WillsanAJantho/Transorter-/Transorter Documents/Poster.jpg

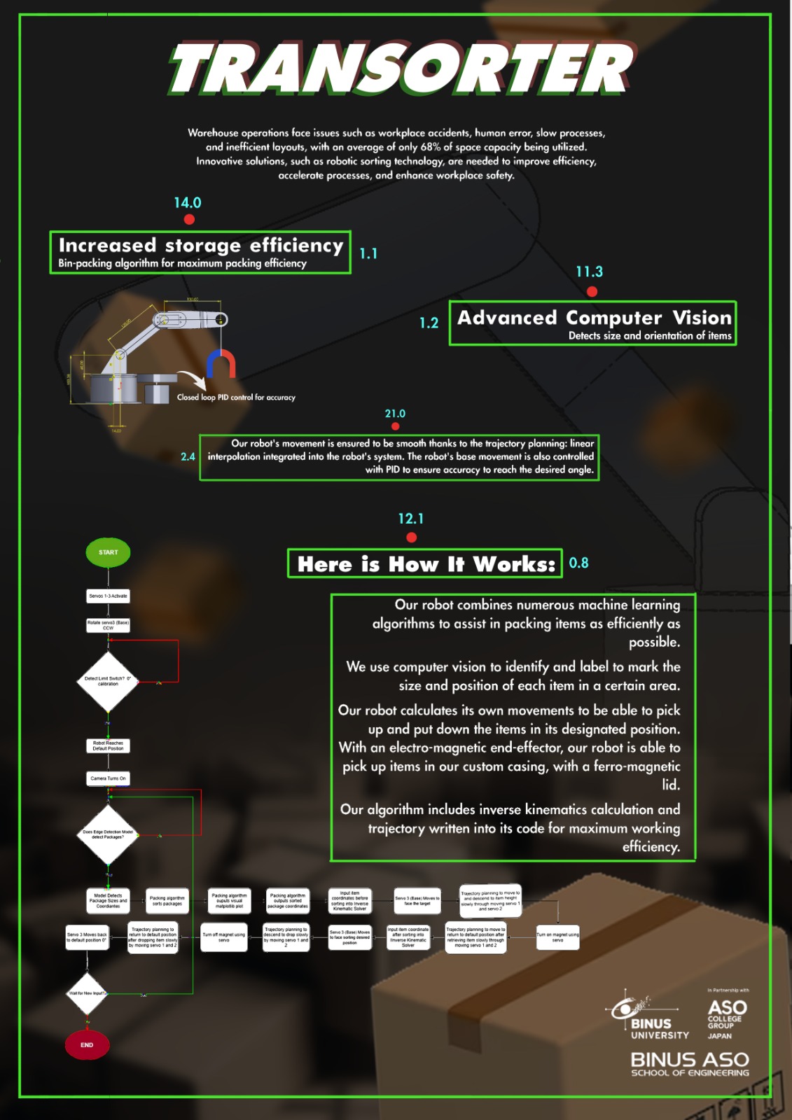
Transorter Documents/Poster.jpg
