WillsanAJantho/Transorter-/Transorter Documents/Laporan TransSorter Final.pdf

# Implementasi Robot Sorting Barang dengan

# Python untuk Machine Learning dan Arduino

# untuk Sistem Kendali

Raphael Nazareth¹

, Samuel Jordan Widjaja¹

, Willsan A Jantho¹

, Efran Leonard Putra Satria¹

, Alifito Marciano Camil¹
,
Dr. Jemie Muliadi, S.T., M.T.²

1Binus ASO School of Engineering, Jl. Alam Sutera Boulevard No.1, Alam Sutera, 15325, Indonesia

2Computer Science Department, School of Computer Science, Bina Nusantara University, Jakarta, 11480, Indonesia

Abstract

Perkembangan teknologi di era modern telah membawa dampak signifikan pada sektor industri, termasuk dalam pengelolaan gudang. Salah satu tantangan utama yang dihadapi dalam operasional gudang adalah kecelakaan kerja akibat sistem penanganan barang yang tidak efisien, serta kesalahan penempatan barang akibat kelalaian pekerja. Selain itu, efisiensi tata letak gudang menjadi isu yang mendesak, mengingat banyak gudang hanya mampu memanfaatkan sebagian kecil dari kapasitas ruang yang tersedia. Untuk menjawab tantangan tersebut, laporan ini membahas penelitian terkait penerapan teknologi robot sorting berbasis machine learning yang terintegrasi dengan sistem kamera untuk melakukan penataan barang secara optimal. Penelitian ini berfokus pada pengembangan dan analisis kinematika serta dinamika lengan robot yang dikendalikan melalui simulasi menggunakan MATLAB, Simulink, dan Simscape. Sistem machine learning diterapkan dengan memanfaatkan algoritma OpenCV untuk identifikasi dimensi barang dan algoritma RectPack untuk optimasi tata letak. Hasil dari penelitian ini diharapkan dapat meningkatkan efisiensi ruang, mempercepat proses penyortiran, serta mengurangi risiko kecelakaan kerja di gudang.

DAFTAR ISI

## BAB I PENDAHULUAN

### 1.1 Latar Belakang

Di era teknologi yang semakin canggih seperti saat ini, perkembangan teknologi memberikan

dampak besar pada sektor industri. Salah satu dampaknya adalah peningkatan kecepatan dan volume

produksi di berbagai industri. Dengan meningkatnya produksi, kebutuhan akan gudang untuk

menyimpan hasil produksi juga meningkat. Namun, banyak permasalahan sering muncul di dalam

operasional gudang. Salah satu permasalahan utama adalah kecelakaan yang terjadi selama proses

penyortiran barang. Hal ini sering kali disebabkan oleh sistem penanganan barang berat yang tidak

tepat, yang dapat membahayakan keselamatan pekerja. Selain itu, banyak gudang masih

mengandalkan tenaga kerja manusia, yang berisiko menimbulkan kesalahan penempatan barang

akibat human error, serta membuat proses penyortiran menjadi lebih lambat [1].

Masalah lainnya adalah tata letak gudang yang tidak efisien. Berdasarkan survei pergudangan

pada tahun 2018, sebagian besar gudang hanya memanfaatkan sekitar 68% dari kapasitas ruang yang

tersedia. Bahkan, hanya 15% gudang yang mampu memanfaatkan 100% kapasitasnya.

Ketidakefisienan ini tidak hanya berdampak pada optimalisasi ruang, tetapi juga memperumit

manajemen logistik di gudang. Oleh karena itu, diperlukan solusi inovatif untuk mengatasi

permasalahan ini, salah satunya adalah dengan menerapkan teknologi modern seperti robot sorting

untuk meningkatkan efisiensi ruang, mempercepat proses, dan meningkatkan keselamatan kerja [2].

### 1.2 Manfaat dan Tujuan Penelitian

Penelitian ini bertujuan untuk mengembangkan sebuah robot yang dilengkapi dengan

microcontroller yang mampu mengintegrasikan kinematika dan dinamika dalam pergerakannya,

sehingga dapat menjalankan tugas penyortiran barang secara presisi dan efisien. Selain itu, sistem

robot ini dirancang untuk memanfaatkan teknologi machine learning dalam bentuk computer vision,

yang memungkinkan robot untuk mengidentifikasi, mengukur, dan mengklasifikasikan benda secara

otomatis berdasarkan data visual. Dengan menggabungkan teknologi ini, sistem mampu

mengoptimalkan proses penataan barang di gudang secara real-time.

Manfaat yang diharapkan dari penelitian ini mencakup tiga aspek utama. Pertama, peningkatan

efisiensi penggunaan ruang di dalam gudang, di mana tata letak barang dapat diatur secara optimal untuk memaksimalkan kapasitas penyimpanan. Kedua, terciptanya lingkungan kerja yang lebih aman

dan terkendali, karena proses penanganan barang berat dan berisiko dapat dialihkan dari pekerja

manusia ke robot, sehingga mengurangi potensi kecelakaan kerja. Ketiga, munculnya peluang

pekerjaan baru yang berfokus pada perawatan dan pengoperasian perangkat berbasis teknologi ini,

yang sejalan dengan kebutuhan tenaga kerja di era industri 4.0.

Adapun inovasi dan aplikasi utama dari penelitian ini meliputi pemanfaatan teknologi

microcontroller dan machine learning untuk meningkatkan efisiensi dalam sektor pergudangan.

Robot yang dikembangkan akan terintegrasi dengan perangkat lunak berbasis computer vision,

memungkinkan proses identifikasi dan penyortiran barang dilakukan secara otomatis dan lebih cepat

dibandingkan metode konvensional. Dengan penerapan teknologi ini, industri pergudangan tidak

hanya dapat meningkatkan produktivitas dan efisiensi, tetapi juga mengadopsi solusi teknologi

canggih untuk menghadapi tantangan masa depan.

### 1.3 Batasan Masalah

Batasan masalah dalam proyek ini dirumuskan sebagai berikut. Barang yang diangkut

berbentuk silinder, sehingga orientasi barang tidak menjadi kendala dan tidak memerlukan rotasi.

Akurasi dalam pengangkutan barang memiliki toleransi sebesar 2–3 cm, yang disebabkan oleh

adanya offset pada end-effector yang tidak sejajar dengan sumbu putar dan desain dari robot memiliki

beberapa kekurangan yang dapat dikembangkan. Selain itu, barang yang diangkat tidak boleh

berwarna hitam, karena sistem machine learning mendeteksi perbedaan warna dalam skala grayscale

dan mengasumsikan alas sebagai warna hitam. Oleh karena itu, warna barang harus lebih terang

dibandingkan dengan warna alas. Sebagai tambahan, barang harus dilengkapi dengan besi pada

bagian atasnya agar dapat diangkat menggunakan magnet.

## BAB II MATERI DAN METODE

### 2.1 Kinematika

Kinematika adalah studi tentang hubungan antara koordinat sendi robot dan posisi spasialnya,

serta merupakan topik fundamental dalam robotika. Untuk mendapatkan posisi yang akurat,

kinematika dapat diselesaikan melalui metode numerik maupun analitis. Misalnya, forward

kinematika memungkinkan kita menentukan posisi end-effector di suatu titik di ruang, merancang

mekanisme yang menggerakkan alat dari titik A ke titik B, atau memprediksi apakah gerakan robot

akan bertabrakan dengan rintangan. Sementara itu, kinematika terbalik atau Inverse kinematic

membantu menghitung nilai sudut setiap sendi yang dibutuhkan untuk mencapai posisi tertentu.

Kinematika hanya memperhitungkan kondisi sesaat koordinat robot, tanpa mempertimbangkan

gerakan yang dipengaruhi oleh gaya atau torsi, yang akan dibahas lebih lanjut dalam dinamika.

Masalah kinematika mungkin terlihat sederhana untuk robot tertentu, seperti robot bergerak yang

dianggap benda kaku, namun membutuhkan kajian lebih mendalam pada robot dengan banyak sendi,

seperti robot humanoid atau mekanisme parallel.

### 2.2 Kinematika Terbalik (Inverse Kinematics)

Dalam dunia robotika, inverse kinematics atau kinematika terbalik adalah salah satu konsep

utama yang digunakan untuk menentukan variabel-variabel pada sambungan robot berdasarkan

posisi dan orientasi yang diinginkan dari efektor akhir (end-effector). Kinematika terbalik bertujuan

untuk menyelesaikan masalah yang berkebalikan dengan forward kinematics, di mana forward

kinematics menghitung posisi dan orientasi dari efektor akhir berdasarkan variabel sambungan yang

diketahui. Pada kinematika terbalik, input utama adalah posisi dan orientasi target dari efektor akhir,

sementara outputnya adalah nilai-nilai variabel pada sambungan, seperti posisi, sudut rotasi, atau

panjang aktuator yang diperlukan untuk mencapai target tersebut. Proses ini melibatkan solusi

persamaan nonlinear yang kompleks, tergantung pada konfigurasi mekanisme robot dan derajat

kebebasannya (Degrees of Freedom, DoFs). Salah satu aplikasi penting dari inverse kinematics

adalah pada kontrol dan pergerakan lengan robot dengan tiga sambungan (three-link arm robot), yang

sering digunakan dalam aplikasi penyortiran barang di gudang atau pengambilan objek pada posisi

tertentu. Three-link arm robot memiliki tiga DoFs yang biasanya berupa rotasi di masing-masing

sambungan. Untuk mencapai posisi yang diinginkan, seperti menjangkau suatu objek pada koordinat tertentu, kinematika terbalik digunakan untuk menghitung sudut rotasi yang diperlukan pada setiap

sambungan.

Sebagai contoh, jika efektor akhir diminta untuk mencapai suatu titik dengan koordinat tertentu

pada bidang dua dimensi (x, y), kinematika terbalik akan menghitung sudut-sudut pada masing-

masing sambungan secara dinamis. Dengan kata lain, kinematika invers menerjemahkan koordinat

target menjadi perintah spesifik berupa sudut rotasi yang harus dicapai oleh masing-masing

sambungan. Pada robot ini, pendekatan matematika yang digunakan melibatkan trigonometri untuk

memecahkan persamaan posisi dari setiap sambungan, dengan mempertimbangkan panjang masing-

masing segmen lengan dan koordinat target. Dalam penelitian ini, kinematika terbalik digunakan

untuk mengatur pergerakan lengan robot yang melakukan proses penyortiran barang di gudang. Hal

ini memastikan efektor akhir dapat mencapai posisi yang diinginkan dengan akurasi tinggi sesuai

kebutuhan. Implementasi kinematika terbalik pada three-link arm robot memberikan solusi yang

efisien untuk berbagai aplikasi robotika, mulai dari pengelolaan inventaris hingga proses manufaktur

presisi [3].

### 2.3 Dynamics

Dinamika robotik adalah bidang studi yang mempelajari perilaku gerak robot sebagai respons

terhadap gaya atau torsi yang diberikan. Dalam robotik, dinamika memainkan peran penting dalam

menjelaskan hubungan antara kontrol (seperti gaya atau torsi pada aktuator) dan perubahan keadaan

robot, termasuk posisi, kecepatan, dan percepatan. Dengan memahami dinamika, kita dapat

merancang kontrol yang memungkinkan robot bergerak secara presisi sesuai dengan tugas yang

diinginkan, meskipun terdapat gangguan atau interaksi dengan lingkungannya. Dinamika robotik

juga memungkinkan prediksi perilaku robot berdasarkan model matematisnya, sehingga sistem

dapat dioptimalkan untuk stabilitas dan efisiensi energi.

Secara umum, model dinamika robot dapat dijelaskan melalui persamaan:

di mana qq adalah posisi sambungan (joint), q˙q˙ adalah kecepatan, dan q¨q¨ adalah

percepatan. Matriks inersia M(q)M(q)menggambarkan distribusi massa robot dan sifat dinamisnya,

sedangkan C(q,q˙)C(q,q˙) mewakili gaya sentripetal dan Coriolis yang muncul akibat gerakan.

Komponen G(q)G(q) melambangkan gaya gravitasi yang bekerja pada robot, dan uu adalah gaya

atau torsi kontrol yang diberikan pada aktuator. Persamaan ini mencakup semua interaksi dinamis

dalam robot, termasuk efek kinematika, inersia, gravitasi, dan gaya-gaya lain yang bekerja pada

sistem.

Dalam implementasi kontrol robot, pemahaman terhadap dinamika sangat penting. Misalnya,

pada sistem kontrol berbasis lintasan, dinamika digunakan untuk menghitung percepatan yang

diinginkan berdasarkan lintasan referensi (qrefqref) yang diinginkan. Selain itu, teknik kontrol

seperti PID (Proportional-Integral-Derivative) atau kontrol ruang operasional memanfaatkan model

dinamika ini untuk mengatur gaya atau torsi sehingga robot dapat mengikuti lintasan dengan presisi

tinggi. Dengan pendekatan ini, robot dapat menangani interaksi yang kompleks, seperti perubahan

beban atau pengaruh lingkungan, dan tetap menjaga kinerja yang optimal [4].

### 2.4 Three Link Planar Robot

Three link planar robot merupakan suatu jenis lengan robot yang memiliki tiga titik sendi,

sehingga robot memiliki sebanyak tiga derajat kebebasan. Dalam membuat sebuah three link planar

robot terdapat beberapa aspek yang perlu dipahami terlebih dahulu. Yang pertama adalah panjang

dari setiap bagian dari lengan pada sebuah robot atau dapat dikatakan jarak antar dua sendi pada robot

yang terdiri dari (I1, I2, I3), dan yang kedua adalah sudut yang dibentuk antara dua sendi pada lengan

robot yang terdiri dari (θ₁, θ₂, θ₃). Sudut pertama pada lengan robot (θ₁) diukur dari sumbu x yang

bersifat tetap, kemudian sendi-sendi selanjutnya (θ₂, θ₃) diukur berdasarkan orientasi pada sendi yang

sebelumnya. Salah satu bagian paling penting dari sebuah lengan robot yaitu end effector merupakan

bagian dari robot yang berinteraksi dengan lingkungan dan memberikan kemampuan bagi robot

untuk menjalankan tugasnya. Dalam sebuah end effector, untuk mengetahui lokasi dari lengannya

x,y, dan φ (phi), perlu didefinisikan terlebih dahulu. x dan y merupakan koordinat yang memberikan

informasi mengenai posisi dari end effector. Sedangkan φ (phi) merupakan sudut yang memberikan

gambaran mengenai posisi dan orientasi end effector [5].

### 2.5 Jacobian

Matriks Jacobian adalah konsep fundamental dalam robotika yang menggambarkan hubungan

matematis antara kecepatan sendi robot manipulator dan kecepatan end-effector. Matriks ini, yang

dilambangkan sebagai J(q), bergantung pada konfigurasi atau posisi robot saat ini. Setiap kolom

dalam matriks Jacobian mencerminkan kontribusi kecepatan dari suatu sendi terhadap kecepatan

linier dan sudut dari end-effector. Secara umum, matriks Jacobian terdiri dari dua komponen utama:

Jv, yang berkaitan dengan kecepatan linier end-effector, dan Jw, yang berhubungan dengan kecepatan

sudutnya. Untuk menghitung Jv, kinematika maju (forward kinematics) digunakan untuk

memodelkan fungsi posisi end-effector (x,y,z) terhadap variabel sendi. Di sisi lain, Jw diperoleh

dengan mempertimbangkan kecepatan sudut, yang dihitung sebagai hasil kali silang antara vektor

sumbu rotasi dengan laju rotasi dari masing-masing sendi. Kombinasi Jv dan Jw menghasilkan

matriks Jacobian lengkap yang memiliki peran penting dalam analisis kecepatan, kontrol gerak, serta

penyelesaian kinematika balik (inverse kinematics). Matriks ini memungkinkan analisis hubungan

antara pergerakan sendi robotik dan gerakan end-effector, menjadikannya alat esensial dalam

pengendalian dan pemrograman robot, khususnya dalam memastikan akurasi dan efisiensi

pergerakan robot [6].

### 2.6 Open CV

Open CV (Open Source Computer Vision Library) adalah pustaka sumber terbuka yang

dirancang khusus untuk aplikasi visi komputer dan pemrosesan gambar secara real-time. Open CV

banyak digunakan dalam berbagai bidang, seperti kecerdasan buatan, robotika, dan augmented reality,

berkat efisiensinya dan kemampuannya yang serbaguna. OpenCV mendukung berbagai bahasa

pemrograman, seperti Python, C++, Java, dan MATLAB, sehingga memudahkan pengembang dari

berbagai platform untuk memanfaatkannya. Selain itu, OpenCV kompatibel dengan sistem operasi

utama seperti Windows, macOS, dan Linux.

Prinsip kerja OpenCV dalam pemrosesan gambar didasarkan pada cara komputer

memperlakukan gambar sebagai kumpulan piksel, di mana setiap piksel direpresentasikan dengan

nilai numerik yang sesuai dengan intensitasnya (untuk gambar grayscale) atau saluran warnanya

(seperti RGB atau format lainnya). Representasi numerik ini memungkinkan komputer untuk

memproses dan menganalisis gambar secara matematis. OpenCV menyederhanakan tugas

pemrosesan gambar yang kompleks dengan menyediakan fungsi-fungsi bawaan untuk operasi seperti

penyaringan gambar, deteksi tepi, ekstraksi fitur, dan transformasi geometris.

Sebagai contoh, dalam proses deteksi tepi, OpenCV menggunakan operasi matematis seperti

perhitungan gradien untuk mengidentifikasi area dalam gambar yang memiliki perubahan intensitas

signifikan, yang biasanya menunjukkan batas objek. Sementara itu, dalam penyaringan gambar,

kernel atau masker konvolusi diterapkan untuk memodifikasi nilai piksel secara sistematis,

memungkinkan tugas seperti pengurangan noise atau penajaman gambar. Desain modular OpenCV

dan algoritma yang dioptimalkan membuatnya menjadi alat yang sangat kuat untuk

mengimplementasikan proses ini dengan efisien, bahkan dalam aplikasi real-time [7].

### 2.7 Rectangle Packing

Algoritma rectangle packing sangat penting dalam grafik komputer dan pengembangan game

untuk menyusun berbagai persegi panjang secara efisien dalam sebuah persegi panjang yang lebih

besar tanpa saling tumpang tindih. Proses ini sangat penting untuk tugas-tugas seperti menyusun

bitmap font ke dalam satu tekstur untuk mengoptimalkan kinerja GPU. Tantangan utama dalam

masalah ini adalah sifatnya yang bersifat NP-hard, yang berarti tidak ada solusi sempurna, sehingga

diperlukan pendekatan heuristik untuk mencapai hasil yang memadai.

Salah satu algoritma yang terkenal dalam bidang ini adalah metode Skyline Bottom-Left (Skyline

BL), yang diimplementasikan dalam pustaka stb_rect_pack. Algoritma ini menggunakan struktur

data yang merepresentasikan “skyline” dari persegi panjang yang sudah disusun, yaitu posisi tepi atas

tertinggi di mana persegi panjang baru dapat ditempatkan. Ketika menempatkan persegi panjang baru,

algoritma ini mencari posisi paling kiri pada skyline di mana persegi panjang tersebut dapat muat,

dengan memastikan penempatannya serendah mungkin. Strategi ini bertujuan untuk meminimalkan

tinggi keseluruhan dari susunan persegi panjang dan mengurangi ruang yang terbuang.

Algoritma Skyline BL bekerja dengan iterasi melalui node dalam linked list yang

merepresentasikan skyline, mengevaluasi potensi posisi untuk persegi panjang baru. Setelah

menemukan tempat yang sesuai, algoritma ini memperbarui skyline untuk mencerminkan

penambahan tersebut, baik dengan menghapus maupun menyesuaikan node yang tumpang tindih

dengan persegi panjang baru. Metode ini menawarkan keseimbangan antara efisiensi dan

kesederhanaan, sehingga menjadi pilihan praktis untuk banyak aplikasi meskipun kompleksitas

masalah rectangle packing cukup tinggi [8].

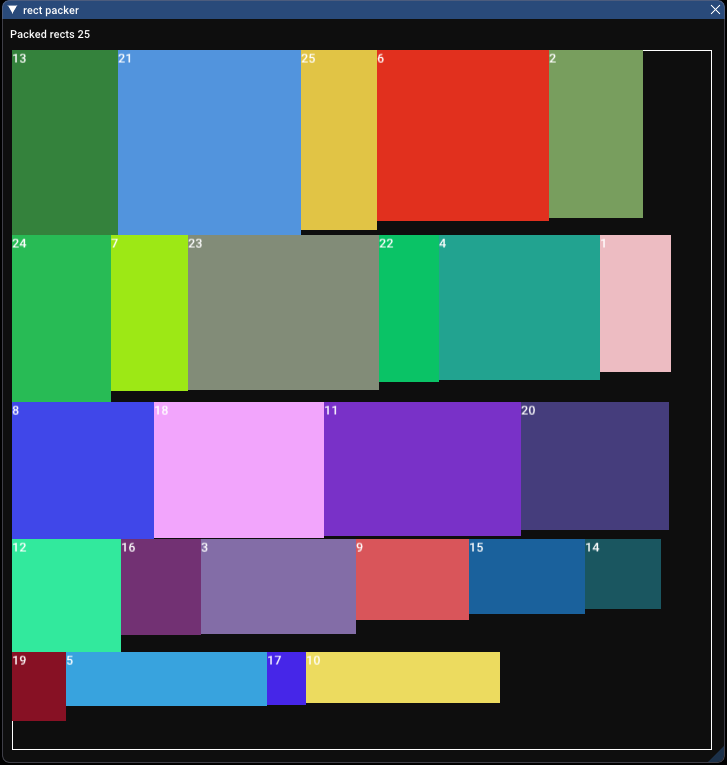
[picture p2: figure]

Figure 1. Rectpack

### 2.8 PID

Kontrol Proportional-Integral-Derivative (PID) adalah salah satu metode sistem kontrol yang

paling banyak digunakan dalam otomasi dan pengendalian proses. Kontroler PID digunakan untuk

terus menerus menghitung nilai error, yaitu selisih antara titik yang diinginkan (setpoint) dan variabel

proses yang terukur. Berdasarkan kesalahan ini, kontroler menerapkan tindakan korektif untuk

menjaga keluaran sistem sedekat mungkin dengan titik setel yang diinginkan. Pendekatan ini sangat

cocok untuk mengatur proses fisik seperti suhu, kecepatan, tekanan, dan tegangan.

Kontroler PID terdiri dari tiga komponen: proportional (P), integral (I), dan derivative (D), yang

masing-masing memberikan kontribusi pada keluaran kontrol. Komponen proportional memberikan

respons langsung terhadap kesalahan saat ini dengan menerapkan koreksi yang sebanding dengan

besarnya kesalahan. Namun, jika hanya bergantung pada komponen proportional, sistem dapat

mengalami kesalahan keadaan tunak (steady-state error), di mana keluaran sistem tetap sedikit

berbeda dari titik setel yang diinginkan.

Komponen integral mengatasi masalah ini dengan mengakumulasi error di masa lalu seiring

waktu dan menerapkan koreksi untuk menghilangkan SSE. Komponen ini mengintegrasikan sinyal

error, memastikan bahwa setiap deviasi yang terus-menerus dari titik setel diperbaiki dari waktu ke

waktu. Namun, komponen integral dapat menyebabkan osilasi dan overshoot jika tidak disetel

dengan benar.

Di sisi lain, komponen derivative memprediksi perilaku sistem di masa depan dengan

menghitung laju perubahan kesalahan. Kemampuan prediktif ini membantu kontroler meredam

osilasi dan meningkatkan stabilitas sistem, terutama pada proses yang mengalami fluktuasi cepat.

Dengan merespons laju perubahan kesalahan, komponen derivative secara efektif memperhalus aksi

kontrol.

Dengan mengkombinasikan ketiga komponen ini, kontroler PID menawarkan strategi kontrol

yang seimbang, meminimalkan kesalahan, mengurangi osilasi, dan meningkatkan stabilitas sistem.

Kontribusi relatif dari komponen P, I, dan D ditentukan dengan menyetel parameter masing-masing,

yang sering disebut nilai gain. Penyelarasan parameter ini sangat penting untuk mencapai kinerja

optimal untuk aplikasi tertentu, karena penyetelan yang tidak tepat dapat menyebabkan

ketidakstabilan atau kontrol yang tidak optimal [9].

### 2.9 ROS

ROS adalah kerangka kerja open-source yang dirancang untuk mengembangkan dan

mengendalikan robot. ROS menyediakan kumpulan alat, pustaka, dan driver untuk membuat aplikasi

robotik yang kompleks. Dengan sistem pesan berbasis publish-subscribe, ROS memungkinkan

komunikasi antara berbagai komponen robot, sehingga mempermudah integrasi sensor, aktuator, dan

algoritma kontrol. ROS mendukung pemrograman multi-bahasa dan desain modular, menjadikannya

fleksibel untuk berbagai platform robot. Ekosistemnya yang luas dengan paket-paket bawaan

mempercepat pengembangan tugas seperti persepsi, navigasi, dan perencanaan gerak [10].

2.10Moveit

MoveIt adalah kerangka kerja perencanaan gerak yang kuat yang dibangun di atas ROS dan

banyak digunakan untuk lengan robotik dan manipulator. MoveIt menawarkan alat untuk inverse

kinematics, perencanaan jalur, deteksi tabrakan, dan optimasi lintasan. MoveIt memungkinkan robot

untuk melakukan pergerakan yang presisi dan aman di lingkungan yang kompleks. MoveIt

terintegrasi dengan baik dengan perangkat keras maupun lingkungan simulasi, menyediakan

visualisasi di RViz dan interaksi dengan pengontrol. Fleksibilitasnya memungkinkan pengembang

untuk menyesuaikan algoritma dan membuat aplikasi untuk tugas seperti pick-and-place, manipulasi

objek, dan pergerakan otonom [11].

### 2.11 Rviz

RViz adalah alat visualisasi di ROS yang memungkinkan pengguna untuk mengamati dan

memeriksa sistem robot dalam lingkungan virtual. RViz dapat menampilkan data sensor, model robot,

lintasan, dan peta secara real-time, sehingga menjadi alat penting untuk memahami bagaimana robot

merasakan dan berinteraksi dengan lingkungannya. Pengembang menggunakan RViz untuk menguji

algoritma, memverifikasi keadaan robot, dan memantau pergerakan tanpa memerlukan perangkat

keras fisik. Dengan arsitektur berbasis plugin, RViz memungkinkan kustomisasi untuk kebutuhan

tertentu, seperti menampilkan visualisasi 3D dari jalur robot atau titik awan dari sensor [12].

2.12Gazebo

Gazebo adalah lingkungan simulasi berbasis fisika untuk menguji dan membuat prototipe sistem

robotik. Gazebo menyediakan pemodelan realistis untuk robot, sensor, dan lingkungan, lengkap

dengan gravitasi, gesekan, dan properti fisik lainnya. Gazebo memungkinkan pengembang untuk

memvalidasi algoritma seperti perencanaan gerak atau navigasi tanpa memerlukan robot fisik.

Simulasi ini terintegrasi dengan baik dengan ROS, memungkinkan pertukaran data antara simulasi

dan node ROS secara mulus. Dengan menyediakan platform yang aman dan hemat biaya, Gazebo

sangat cocok untuk pengembangan cepat, pengujian, dan pelatihan model pembelajaran mesin untuk

aplikasi robotik [13].

2.13Alat & Bahan

### 2.12.1 Alat

- Servo 360
- Servo 180
- Komponen 3D print
- Rotary encoder
- Elektromagnet
- Limit switch
- Power supply

### 2.12.2 Bahan

- SolidWorks, untuk melakukan pemodelan robot
- Matlab, simulink, simscape, untuk membuat simulasi robot dan tuning PID
- Visual Studio Code, untuk menjalankan machine learning

## BAB III PROSEDUR

Hal pertama yang dilakukan dalam perancangan robot sorting adalah menentukan end effector

yang akan digunakan. Pilihan end effector yang dipertimbangkan mencakup gripper dan suction.

Namun, pilihan akhir jatuh pada end effector berupa elektromagnet karena dinilai lebih efisien dan

praktis baik dari segi pembuatan maupun penggunaan. Setelah end effector ditentukan, langkah

berikutnya adalah memilih algoritma machine learning yang sesuai. Algoritma yang dipilih meliputi

OpenCV untuk image processing dan pengukuran dimensi benda, serta algoritma Rectangle Packing

untuk mengatur tata letak barang agar lebih efisien.

Selanjutnya, pemilihan komponen robot dilakukan dengan memperhatikan kinerja dan performa

sistem secara keseluruhan. Komponen utama yang digunakan mencakup servo motor, lengan robot,

dan sensor. Servo motor terdiri dari dua jenis: servo 180° (positional) untuk pergerakan terbatas

dengan sudut rotasi tertentu, dan servo 360° (continuous) yang digunakan pada basis robot untuk

memungkinkan rotasi penuh. Servo 360° ini dilengkapi dengan rotary encoder yang berfungsi untuk

membaca rotasi dengan presisi yang cukup tinggi sehingga dapat mencapai sudut yang diinginkan.

Lengan robot dirancang agar memiliki bobot seringan mungkin untuk menghindari beban

berlebih pada servo, memastikan servo dapat beroperasi dengan optimal. Perancangan lengan juga

mempertimbangkan pusat massa dan daya tahan material untuk menjaga stabilitas dan keandalan

sistem. Sensor rotary encoder diintegrasikan pada servo base untuk memberikan kontrol yang lebih

akurat terhadap sudut rotasi.

Dengan langkah-langkah ini, perancangan robot dilakukan secara sistematis sehingga setiap

komponen dan algoritma dapat bekerja secara harmonis untuk mendukung efisiensi dan performa

robot yang maksimal.

Robot ini memanfaatkan teknologi 3D design dalam perancangannya sehingga dapat

menciptakan sebuah struktur robot yang kokoh. Part untuk robot ini dirancang menggunakan

software SolidWorks dan setelah banyak revisi rancangan yang dilakukan hasil akhir bentuk dari

robot ini seperti pada gambar di bawah ini.

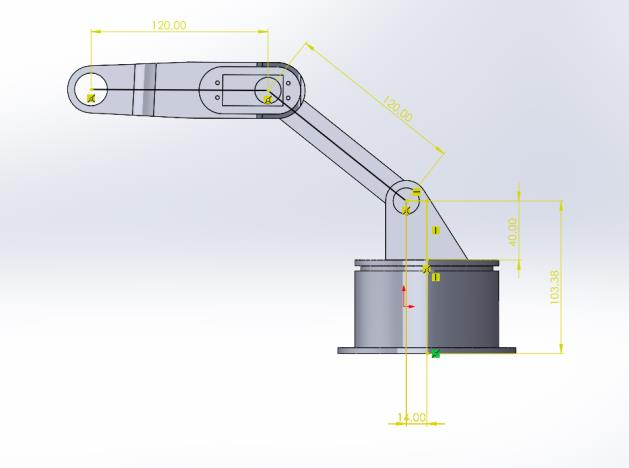
[picture p3: figure]
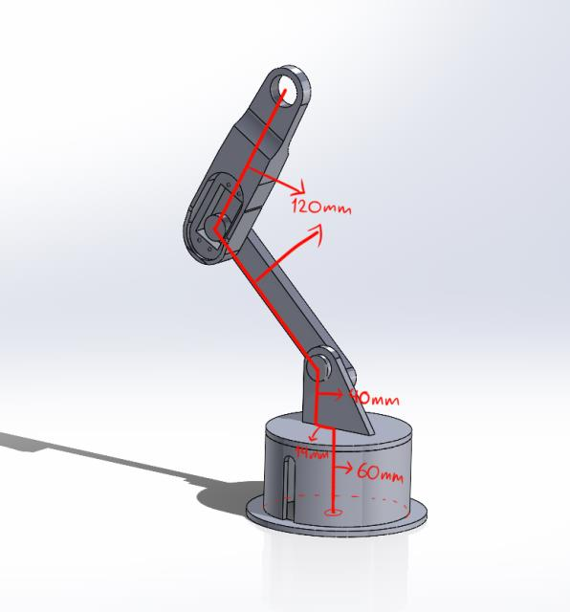
[picture p4: figure]

Berdasarkan gambar di atas, penempatan servo yang digunakan dalam robot ini adalah pada

kedua sendi robot yang merupakan lengan dari robot tersebut yang menggunakan servo 180 dan pada

alas dari robot yang menggunakan servo 360 yang bertujuan untuk mengatur arah robot tersebut

menghadap untuk saat mengambil barang.

Untuk mengidentifikasi koordinat dan ukuran benda berbentuk silinder yang akan diambil,

sebuah kamera digunakan dan diletakkan tepat di atas area penyimpanan awal benda. Dengan

menggunakan kamera tersebut, algoritma computer vision yang didukung oleh OpenCV diterapkan.

OpenCV memungkinkan identifikasi benda berdasarkan fitur visual seperti bentuk melingkar,

diameter, dan posisi koordinat. Setelah koordinat dan ukuran benda berhasil dideteksi, algoritma

Figure 2. Robot Dimensions & Design

Rectpack dapat disesuaikan untuk menyusun tata letak benda-benda berbentuk lingkaran secara

efisien dalam suatu area terbatas. Rectpack, meskipun umumnya dirancang untuk objek berbentuk

persegi panjang, dapat dimodifikasi atau digabungkan dengan pendekatan lain untuk menangani

benda berbentuk bulat. Kombinasi algoritma ini memungkinkan sistem untuk mengidentifikasi,

mengatur, dan memanfaatkan ruang penyimpanan dengan lebih optimal sesuai dengan bentuk benda.

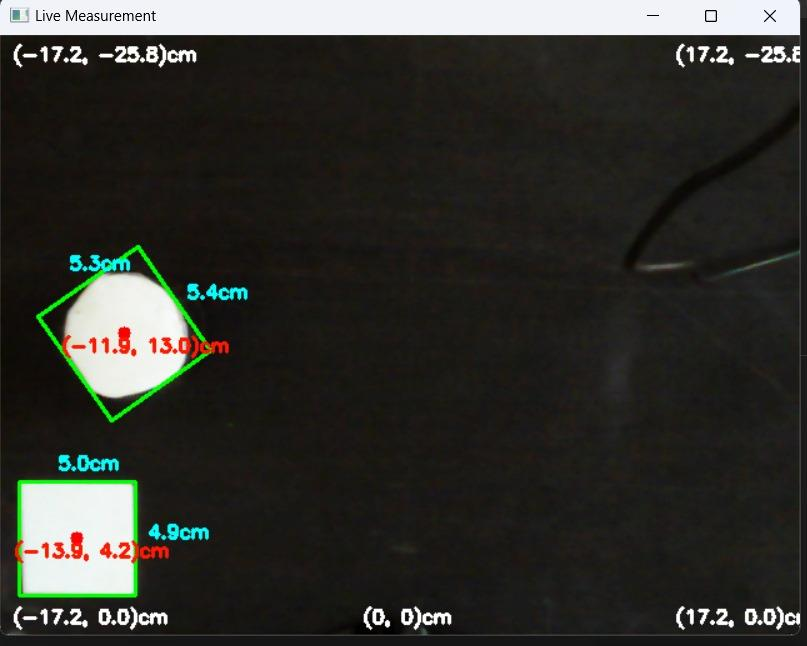
[picture p5: figure]

Figure 3. Live Camera Measurement (OpenCV)

Pada gambar di atas, kita dapat melihat cara kerja OpenCV, pertama, OpenCV memanfaatkan

kemampuan edge detection, untuk mengetahui batas-batas objek yang terdeteksi dan memberikan

ukuran ukuran. Kemudian kita menggunakan kemampuan pemetaan koordinat/piksel untuk

mendeteksi lokasi/koordinat objek silinder. Kubus yang terlihat di kiri bawah gambar diatas berfungsi

sebagai titik referensi yang diatur secara manual, untuk memastikan bahwa untuk memastikan skala

pengukuran sudah akurat.

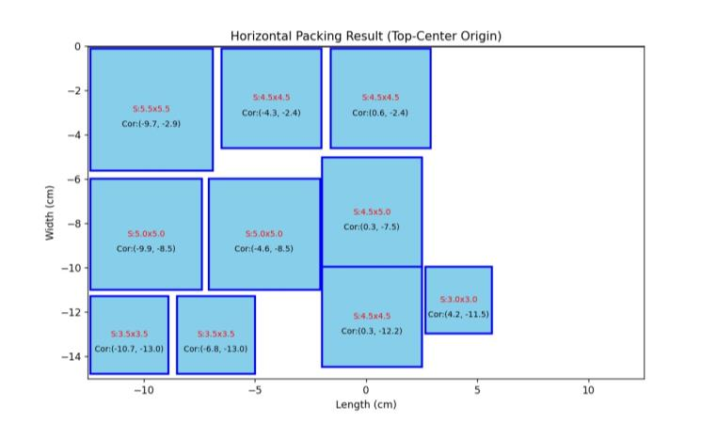
[picture p6: figure]

Figure 4. Rectpack result

Setelah deteksi ukuran dan posisi objek silinder dilakukan oleh OpenCV, variabel-variabel

tersebut kemudian dimasukkan ke dalam algoritma 2D-bin packing yang dikenal sebagai rectpack.

Algoritma packing ini kemudian memproses silinder, yang telah ditafsirkan ulang sebagai kotak dan

atau persegi panjang, dan menghasilkan cara pengemasan yang optimal berdasarkan perhitungannya.

Hasil dari algoritma ini kemudian ditampilkan secara visual di layar kepada user melalui penggunaan

library matplotlib. Memungkinkan pengguna untuk melihat koordinat silinder setelah di packing.

Sebelum dilakukan pengerjaan yang lebih lanjut untuk robot, dilakukan simulasi gerak robot

yang dilakukan dalam matlab, simulink, simscape, dan ROS.

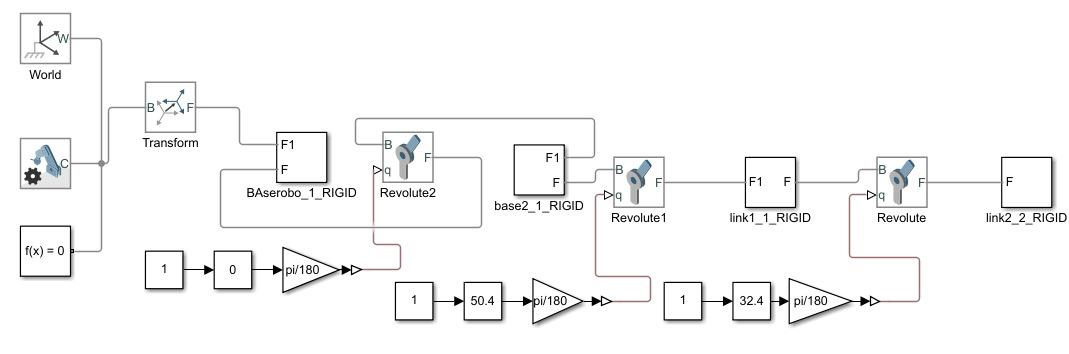
[picture p7: figure]

Figure 5. Model Simscape Robot

Model Simscape yang ditampilkan merupakan simulasi untuk robot 3 link yang dirancang

menggunakan komponen rigid dan sambungan revolute. Sistem ini dimulai dengan kerangka

referensi dunia (World Frame) yang menjadi acuan utama posisi dan orientasi robot dalam ruang 3D.

Transformasi digunakan untuk menghubungkan dunia ke basis robot, memungkinkan integrasi gerakan dengan lingkungan simulasi. Robot terdiri dari tiga sambungan revolute, masing-masing

memungkinkan gerakan rotasi yang merepresentasikan derajat kebebasan (DOF) pada setiap joint.

Sambungan ini menggerakkan komponen rigid yang membentuk struktur fisik robot, seperti basis,

link 1, dan link 2. Input kontrol diberikan dalam bentuk nilai rotasi, yang kemudian dikonversi dari

derajat ke radian agar sesuai dengan perhitungan simulasi. Setiap gerakan dihitung berdasarkan

hubungan antar joint dan link, menghasilkan visualisasi kinematika robot, termasuk pergerakan ujung

robot (end-effector). Secara keseluruhan, model ini memungkinkan analisis kinematika dan validasi

desain robot 3 link sebelum diterapkan secara fisik.

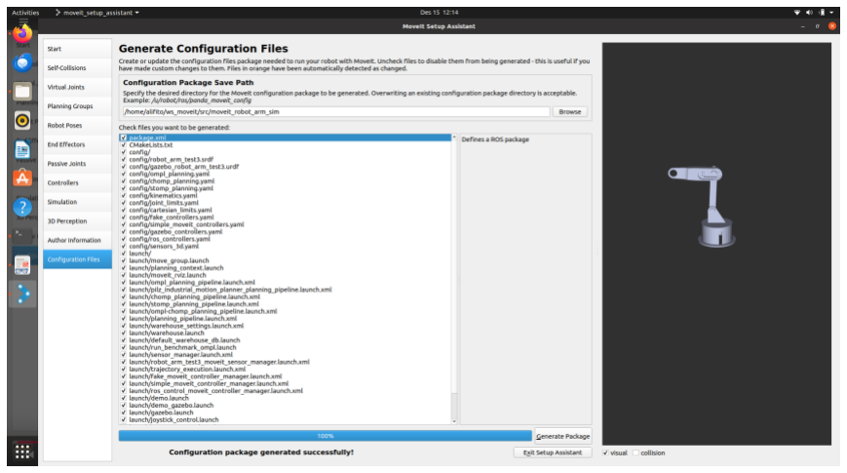
[picture p8: figure]

Figure 6. Model ROS

Model robot pada gambar di atas telah diimpor ke MoveIt dari SolidWorks menggunakan

ekstensi SW2URDF yang memungkinkan pengguna untuk mengekspor model SolidWorks sebagai

file URDF untuk ROS. Robot ini memiliki konfigurasi 3-DOF dengan tiga joint revolute: dua pada

lengan dan satu pada pangkalan (base). Joint pada lengan memungkinkan rotasi hingga 180 derajat,

memberikan fleksibilitas untuk melakukan tugas seperti mengambil, meletakkan, atau bermanuver di

dalam ruang kerja semi-sferis. Sementara itu, joint pada pangkalan mendukung rotasi penuh 360

derajat, memungkinkan robot untuk beroperasi di seluruh area melingkar tanpa perlu reposisi.

Konfigurasi ini membuat robot sangat cocok untuk aplikasi yang membutuhkan fleksibilitas dan

jangkauan gerak yang luas, seperti manipulasi objek, penyortiran, atau tugas perakitan sederhana.

Paket MoveIt yang dihasilkan menyediakan kemampuan perencanaan kinematika, pemeriksaan

tabrakan, dan perencanaan lintasan, sehingga robot dapat melakukan pergerakan secara efisien dan

aman baik dalam simulasi maupun lingkungan dunia nyata.

Berikut ini merupakan kalkulasi dan aplikasi dari teori robotic kinematics & dynamics yang kami

gunakan dalam proyek ini:

1. Kinematics

Robot yang digunakan merupakan robot dengan 3-DOF, terdiri dari 2-link planar arm dan

satu servo motor 360 derajat yang berfungsi untuk memutar base robot. Oleh karena itu,

analisis akan dimulai dengan menghitung sudut pada 2-link planar arm (θ1 dan θ2).

Selanjutnya, sudut pada joint ketiga (θ3) akan dihitung menggunakan fungsi arctan untuk

menentukan rotasi pada base robot.

Perhitungan 2 link arm :

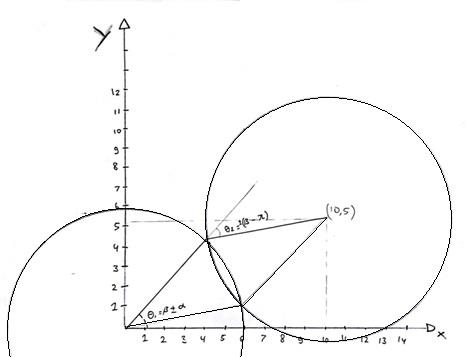
[picture p9: figure]
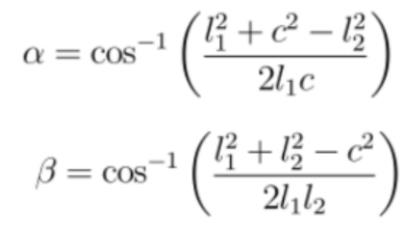
[picture p10: figure]

L1 = Panjang link 1

L2 = Panjang link 2

c = √a
2 + b

2

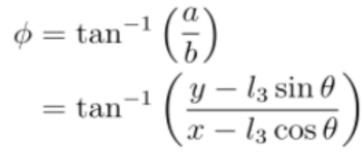
[picture p11: figure]

Kemudian sudut ini dapat dicari dengan cara :

c = √10² + 5
2 = √100 + 25 = 5√5

α = cos⁻¹ (
12² + √125

2
− 12²
2 (12)(12)

) = 62

β = cos⁻¹

(
12²+ 12²−√125

2

2 (12)(12)

) = 55

θ = tan⁻¹

(

5
10) = 26

θ1 = β ± α

θ2 = ±(β − π)

θ1 = 26 ± 62 = 88,−36

θ2 = ±(55 − 180) = ±(−125)

2. Dynamics

Dalam proyek ini, dinamika digunakan untuk menganalisis dan menentukan kekuatan

maksimum yang dapat dicapai oleh lengan robot.

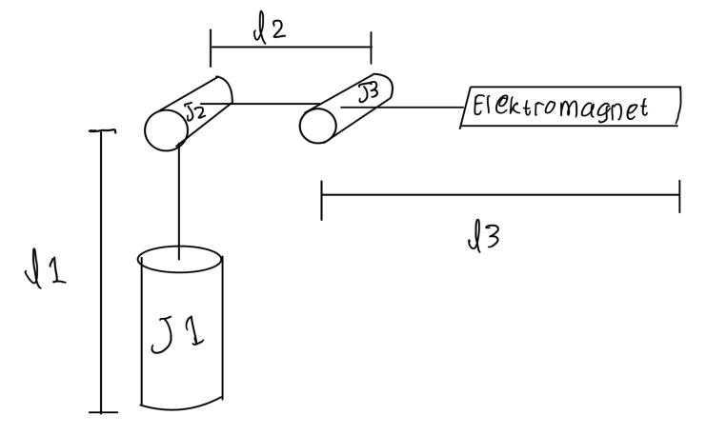
[picture p12: figure]

Figure 7. Robot Dynamics

Dinamika dalam proyek ini dimulai dengan perhitungan pada sendi ketiga dari robot, yang berfungsi

sebagai lengan untuk mengangkat benda. Oleh karena itu, torsi pada lengan ketiga perlu dihitung. Titik pusat massa dari benda yang diangkat berada pada jarak l3 dari sumbu rotasi sendi ketiga.

Ketika sudut lengan berada pada 0 derajat, jarak titik pusat massa benda adalah l3
. Namun, jika lengan
membentuk sudut tertentu, maka jarak efektifnya menjadi l3cos⁡(x). Gaya gravitasi yang bekerja

pada benda ditentukan oleh massa benda (Mbenda) dikalikan dengan percepatan gravitasi (g), yang dirumuskan sebagai Wbenda = Mbenda * g

Akibatnya, torsi total yang dihasilkan oleh sendi ketiga pada benda yang diangkat dapat dirumuskan

sebagai:

τ = l3cos(x) ⋅ Wbenda

Titik pusat massa dari lengan 3 berada pada sendi ketiga dan end-effector (elektromagnet) yang terletak pada jarak l3

2

dari sumbu rotasi. Ketika sudut xx tidak bernilai nol, posisi titik pusat massa lengan 3 berada pada jarak l3

2

cos(x). Dengan demikian, torsi pada lengan 3 dapat dirumuskan

sebagai:

torque2 = ( l3cos(x) ⋅ Wbenda) + (

l3
2

cos(x).Wlink3)

Untuk sendi kedua, diperlukan perhitungan torsi yang meliputi beban dari benda, lengan 3, dan

lengan 2. Setelah semua torsi di atas dihitung, torsi total pada sendi kedua dapat dinyatakan

sebagai:

torque2 = ((l2cos(x) + l3cos(x)) ⋅ Wbenda) + (l2cos(x) +

l3
2

cos(x)) ⋅ Wlink3

) + (l2cos(x)

⋅ Wjoint3

) + (

l2
2

cos(x) ⋅ Wlink2

)

Pada sendi pertama (l1
), torsi bernilai nol karena lengan robot yang digunakan tidak memiliki torsi

yang bekerja pada sendi ini. Hal ini disebabkan oleh fakta bahwa semua gaya menuju ke sendi 1

melalui sendi 2, sehingga Torque1=0

torque1 = 0

Kemudian berikut ini merupakan aplikasi dari rumus yang telah dipaparkan ke dalam robot sorting

gudang

Link 2,3 = 12cm (0.12m)

Massa benda = 50 gram (0.05kg)

Massa link 3 =47gram (0.047kg)

Massa link 2 = 35gram (0.035kg)

Joint 2,3 = 55 gram (0.055kg)

torque3 = (0.12cos(0) ⋅ 0.05) + (

0.12

2

cos(0) ⋅ 0.047)

torque3 = 0.006 + 0.00282 = 0.00882Nm torque2 = (0.12cos(0) + 0.12cos(0)) ⋅ 0.05) + (0.12cos(0) +

0.12

2

cos(0)) ⋅ 0.047)

+ (0.12cos(0) ⋅ 0.055) + (

0.12

2

cos(0) ⋅ 0.035)

torque2 = 0.126 + 0.12282 + 0.0066+ 0.0021 = 0.25752Nm

Perhitungan di atas merupakan besarnya torsi yang bekerja pada sendi2 dan sendi3.

Control System

Dikarenakan PID akan diaplikasikan ke dalam sistem robot, yaitu pada bagian servo 360° yang

terdapat pada alas, maka harus dicari tahu transfer function dari komponen tersebut. Oleh karena itu,

perlu diturunkan dari diagram servo yang didapatkan dari publikasi berjudul “Physical Modeling and

Parameters Identification of the MG995 Servomotor” [14].

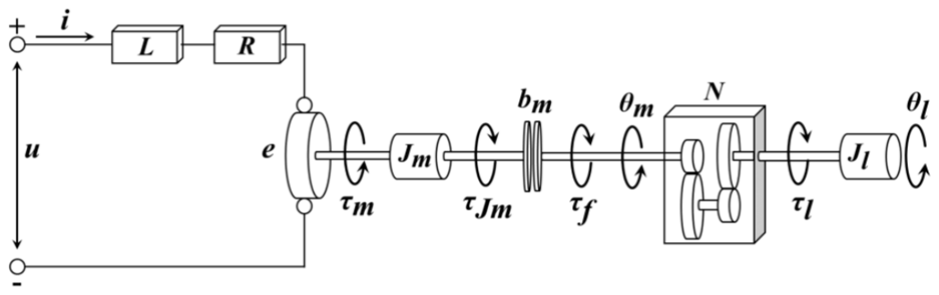
[picture p13: figure]

Figure 8. Diagram servo MG995

Dari diagram di atas, didapatkan beberapa variabel. Di mana u adalah tegangan yang diberikan ke

terminal motor, i adalah arus listrik, R adalah hambatan motor, L adalah induktansi, dan e adalah

gaya gerak listrik balik. Unsur mekanisnya adalah τm yang merupakan torsi yang dihasilkan motor,

Jm adalah momen inersia motor, bm adalah koefisien gesek viskos, τf adalah torsi gesek viskos, θm

adalah sudut putaran poros motor, N adalah rasio roda gigi gearbox, Jl adalah momen inersia beban

yang dipasang pada poros keluaran servo, τl adalah torsi yang diterapkan pada beban pada poros

keluaran dan, terakhir, θl adalah sudut rotasi poros keluaran servo.

Dari sumber yang sama, juga didapatkan nilai-nilai untuk variabel-variabel tersebut.

Variable (symbol) | Value | Variable (symbol) | Value

Motor Polar Moment of Inertia (Jm) | 6.3173*(10⁻⁷ ) kg·m² | Gear ratio (N) | 275.6923
Viscous Friction Coefficient (bm) | ) Nms 2.49797*(10⁻⁷ | Gearbox Efficiency Factor (μ) | 0.81156
Motor Resistance (R) | 2.5 Ω | Torque Constant (Kt) | 5.8857*(10⁻³ ) N·m/A
Inductance (L) | 0 | Load Polar Moment of Inertia (Jl) | 0.00216 kg·m²

L ≈ 0 karena dinamika kelistrikan jauh lebih cepat dibandingkan dengan dinamika mekanis,

dikarenakan konstanta waktu R/L jauh lebih kecil dibandingkan konstanta waktu mekanis.

Untuk mencari nilai Jl di atas, perlu dilakukan tahap-tahap berikut:

1. Simplify bentuk dari robot

Untuk mempermudah proses kalkulasi, bentuk lengan robot disederhanakan menjadi balok.

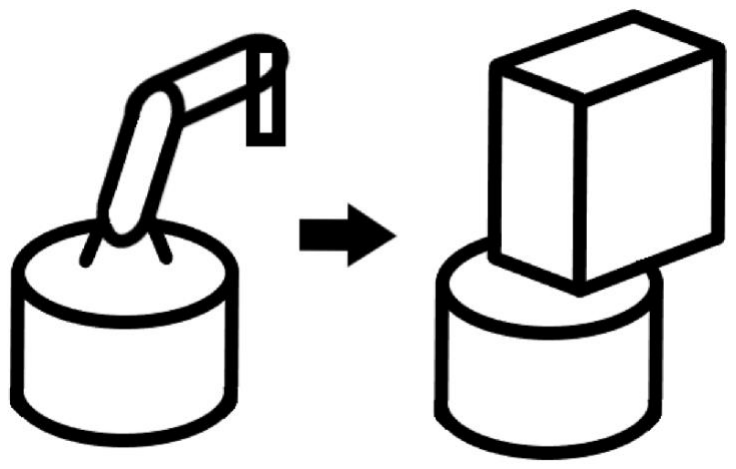
[picture p14: figure]

Figure 9. Gambaran simplifikasi bentuk lengan robot untuk mempermudah kalkulasi

2. Formula yang digunakan
3. Tentukan nilai dari barang: Mass (m) = 450g, Length (L) = 12cm
4. Kalkulasi

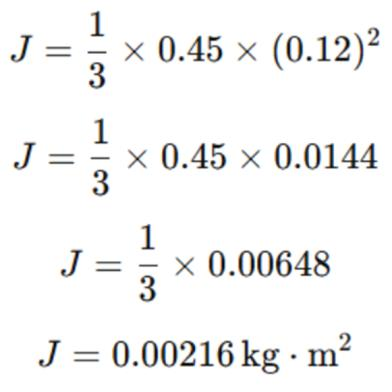
[picture p15: figure]

Untuk mencari transfer function dari sistem, perlu dilakukan seperti berikut:

1. Persamaan keseimbangan torsi motor servo
2. Daya pada poros keluaran berkaitan dengan daya poros masukan yang dikurangi dengan

efisiensi gearbox

3. Terapkan power loss ke persamaan torsi
4. Ubah persamaan sebelumnya menggunakan transformasi Laplace, manipulasi aljabar, dll.

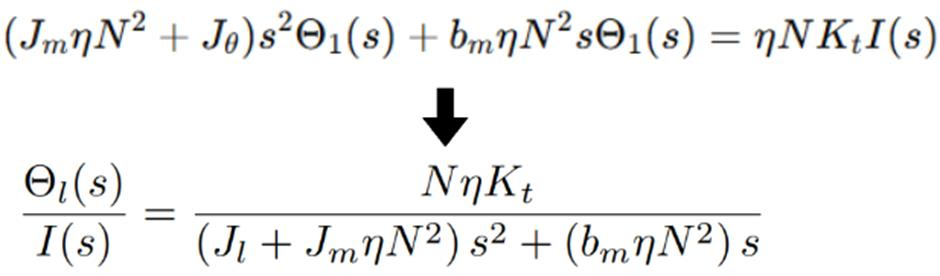
[picture p16: figure]

5. Persamaan tegangan motor
6. Transformasi Laplace persamaan tegangan motor

7. Gabungkan persamaan 6 ke persamaan 4

Perlu dilakukan perubahan pada bentuk persamaan menjadi seperti berikut agar mudah diproses

dalam MATLAB:

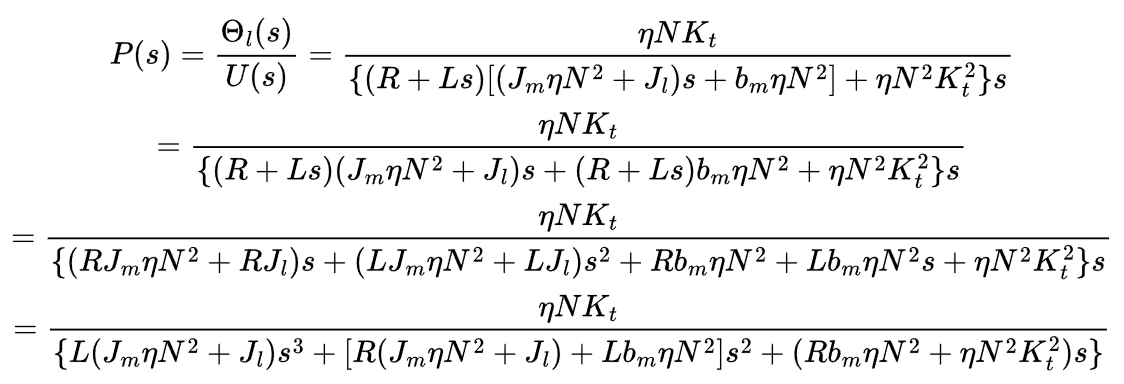
[picture p17: figure]

Setelah didapatkan transfer function di atas, substitusi nilai-nilai yang diketahui ke dalam fungsi,

sehingga mendapatkan fungsi berikut

1.31687148
0.09957849517s

2+2.175332158s

Karena sistem di atas masih dalam bentuk continuous, maka perlu diproses menggunakan ZOH agar

menjadi discrete.

Zero-Order Hold (ZOH) adalah metode yang banyak digunakan untuk merekonstruksi sinyal secara

real time. Dalam metode rekonstruksi penahan orde nol, sinyal kontinu direkonstruksi dari sampelnya

dengan menahan sampel tertentu selama jangka waktu tertentu hingga sampel berikutnya diterima.

Oleh karena itu, ZOH menghasilkan perkiraan langkah.

Berikut adalah gambaran dari proses rekonstruksi ulang sinyal menggunakan ZOH:

Figure 10. Proses cara kerja ZOH

Berikut adalah proses konversi menggunakan MATLAB:

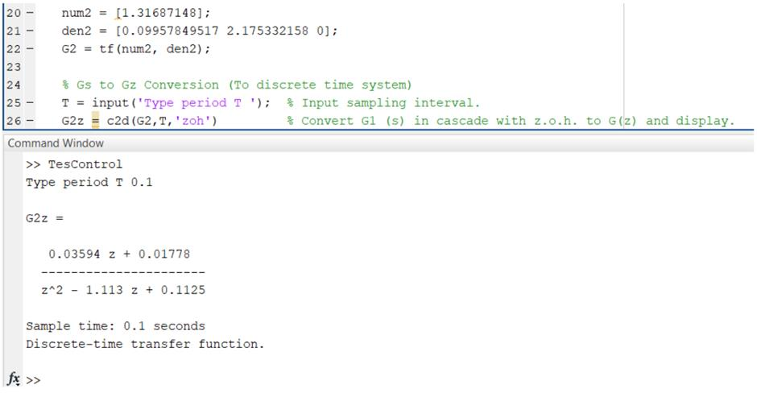
[picture p18: figure]

Figure 11. Proses konversi transfer function dari kontinuous menjadi diskrit menggunakan MATLAB

Sehingga didapatkan perubahan seperti berikut

1.31687148
0.09957849517s

2+2.175332158s

=>

0.03594z+0.01778
z

2−1.113+0.1125

Setelah mendapatkan sistem discrete di atas, dapat dikeluarkan root locus dari fungsi tersebut untuk

menentukan nilai gain untuk mendapatkan damping yang diinginkan. Seperti dalam gambar di bawah,

dapat dilihat bahwa ada dua titik yang dipilih. Yang berwarna kuning adalah nilai gain yang perlu

digunakan untuk mendapatkan damping sebesar 0.49. Yang berwarna hijau adalah nilai gain yang

perlu digunakan untuk mendapatkan damping sebesar 1, yaitu saat gain bernilai 5.47.

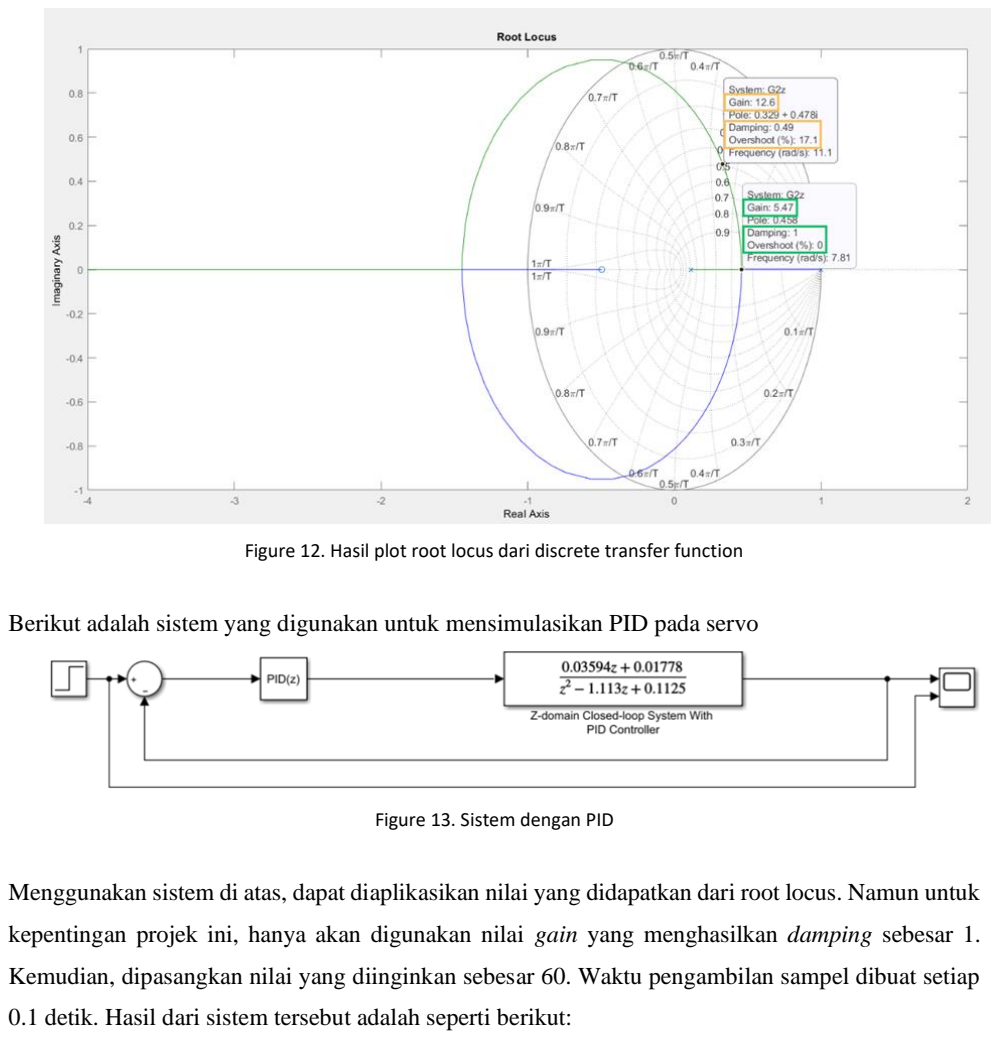
[picture p19: page 28]

Figure 12. Hasil plot root locus dari discrete transfer function

Berikut adalah sistem yang digunakan untuk mensimulasikan PID pada servo

Figure 13. Sistem dengan PID

Menggunakan sistem di atas, dapat diaplikasikan nilai yang didapatkan dari root locus. Namun untuk

kepentingan projek ini, hanya akan digunakan nilai gain yang menghasilkan damping sebesar 1.

Kemudian, dipasangkan nilai yang diinginkan sebesar 60. Waktu pengambilan sampel dibuat setiap

0.1 detik. Hasil dari sistem tersebut adalah seperti berikut:

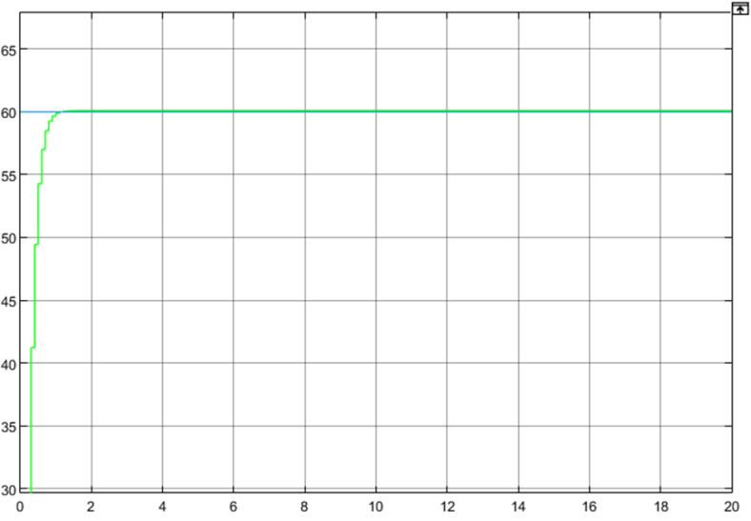
[picture p20: figure]

Figure 14. Hasil plot sistem dengan PID

Dapat dilihat bahwa sistem mencapai kestabilan di nilai yang diinginkan dalam waktu kurang dari 1

detik. Namun untuk sistem ini, juga perlu ditambahkan saturasi. Alasan digunakannya saturasi adalah

sebagai pembatas voltase input dengan batas terendah sebesar -12 dan batas tertinggi sebesar +12

untuk membatasi tegangan input agar tidak membebani servo yang berisiko merusak servo. Waktu

pengambilan sampel masih dibuat setiap 0.1 detik. Berikut adalah sistem dengan PID dan saturasi:

Figure 15. Sistem dengan PID dan saturasi

Menggunakan sistem di atas, didapatkan hasil di bawah saat menggunakan parameter PID dan input

yang sama seperti sistem sebelumnya.

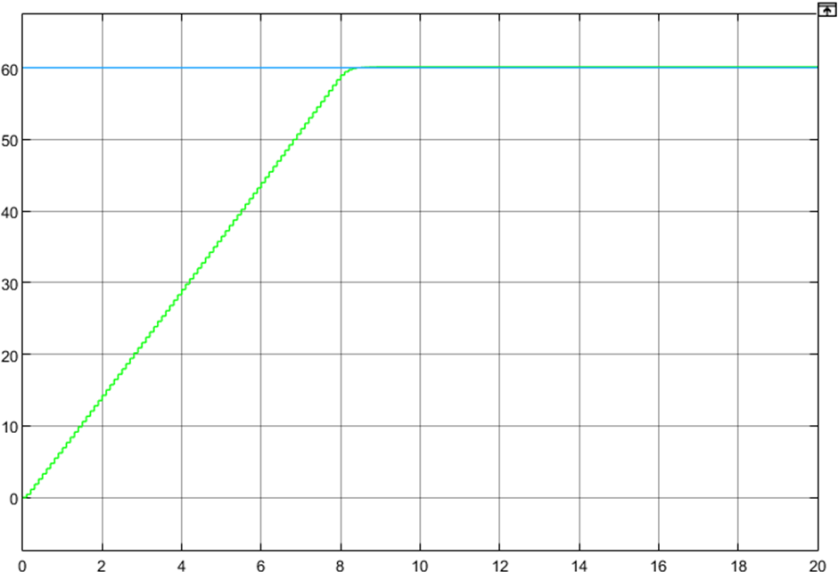
[picture p21: figure]

Figure 16. Hasil plot sistem dengan PID dan saturasi

Flowchart

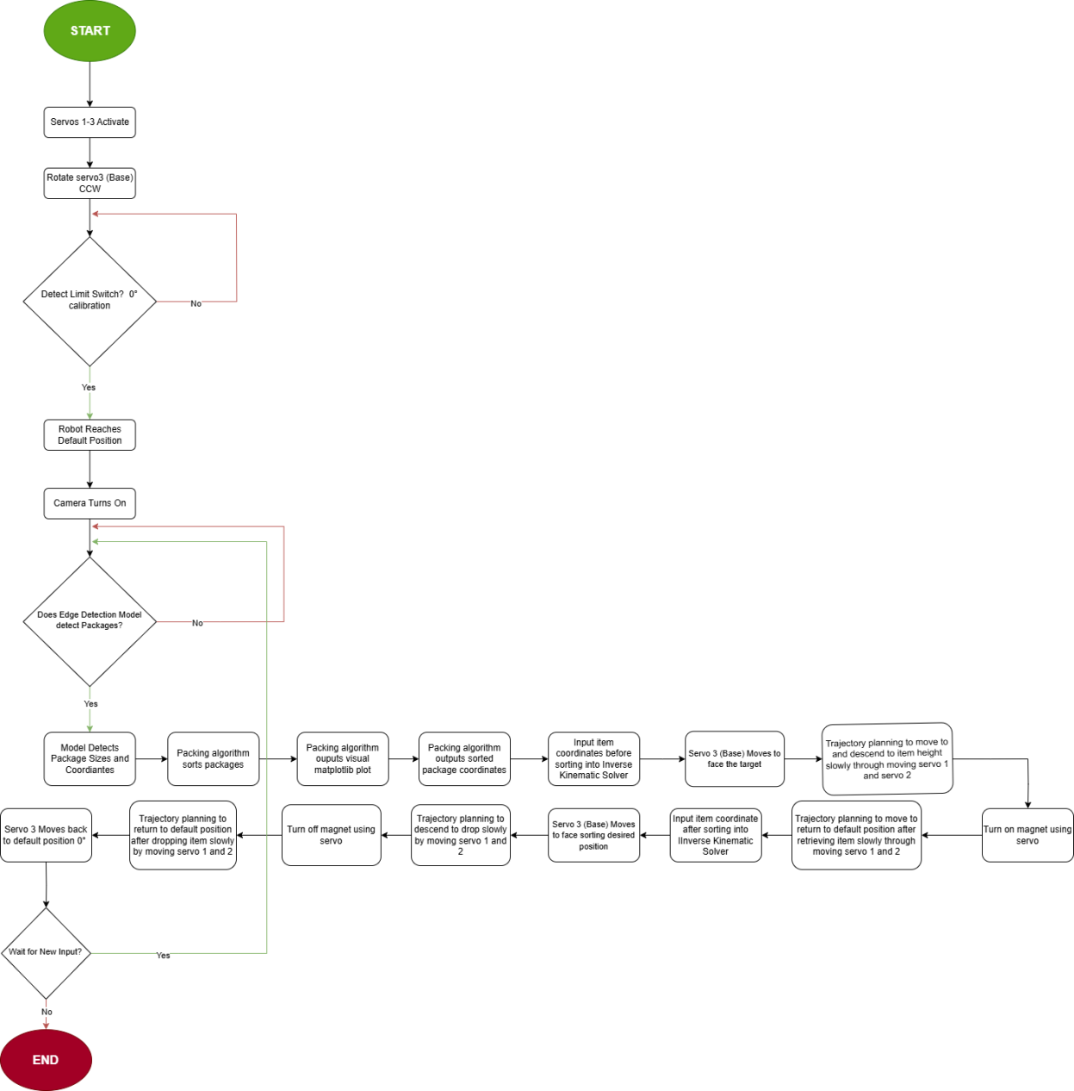
[picture p22: figure]

Figure 17. Diagram Flowchart

Diagram di atas menunjukkan flowchart seluruh sistem kami. Dimulai dengan aktivasi ketiga servo,

setelah itu servo base bergerak hingga mencapai limit switch. Setelah mencapai limit switch, servo

akan berhenti, mencapai posisi default. Setelah itu, kamera menyala dan mencari objek, ukuran dan

variabel koordinat objek yang terdeteksi dimasukkan ke dalam algoritma packing rectpack.

Algoritma ini kemudian mengeluarkan koordinat yang ideal untuk pengemasan setiap objek yang

terdeteksi menurut perhitungannya.

Setelah proses packing selesai, koordinat objek sebelum packing di input ke dalam Inverse

Kinematics Solver dan servo bergerak sesuai dengan trajectory planning untuk mengambil objek

supaya lengan robot dan objek tersebut tidak bertabrakan dengan apa pun. Inverse Kinematics Solver

kemudian diberi koordinat objek yang sama setelah packing dan servo-servo kemudian bergerak

sesuai dengan trajectory planning untuk memindah objek ke lokasi pengemasan.

## BAB IV HASIL DAN PEMBAHASAN

### 4.1 Hasil Pembuatan Robot

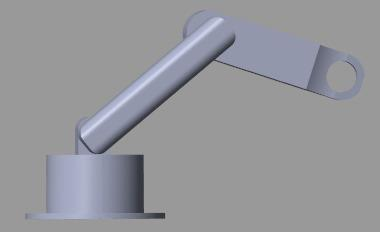
[picture p23: figure]

Figure 18. Hasil Simulasi Simscape

Pada hasil simulasi menggunakan model Simscape untuk robot 3 link, end-effector belum dapat

dimodelkan karena keterbatasan dalam merepresentasikan elektromagnetik pada lingkungan

Simscape. Namun, berdasarkan pengujian yang telah dilakukan, struktur lengan, sendi, servo, dan

end-effector telah berfungsi dengan baik secara fisik. End-effector elektromagnetik mampu

mengangkat objek dengan akurat, tetapi tidak dapat beroperasi dalam jangka waktu lama karena

panas yang dihasilkan dapat menghilangkan sifat magnet penghantarnya. Untuk sendi yang

menggunakan servo 180°, pengujian menunjukkan hasil yang akurat, di mana setiap servo mampu

menjalankan trajectory planning dengan tepat sesuai dengan nilai theta yang dihasilkan melalui

metode machine learning.

Servo pada alas, yang menggunakan servo 360°, juga menunjukkan performa yang cukup akurat.

Namun, terdapat keterbatasan teknis di mana servo harus kembali ke posisi 0° sebelum menuju sudut tujuan. Hal ini disebabkan oleh keterbatasan pada perangkat, khususnya pada feedback dari rotary

encoder, yang memiliki limitasi dalam pergerakan dua arah. Dari sisi struktur lengan, pengujian

menunjukkan bahwa lengan telah memenuhi spesifikasi yang diinginkan. Lengan mampu menahan

torsi yang dihasilkan selama operasi dengan baik, sehingga mendukung stabilitas dan akurasi gerakan

secara keseluruhan. Hasil ini menunjukkan bahwa sistem robot secara keseluruhan telah bekerja

sesuai harapan, meskipun ada beberapa batasan yang memerlukan perhatian lebih lanjut untuk

pengembangan di masa depan.

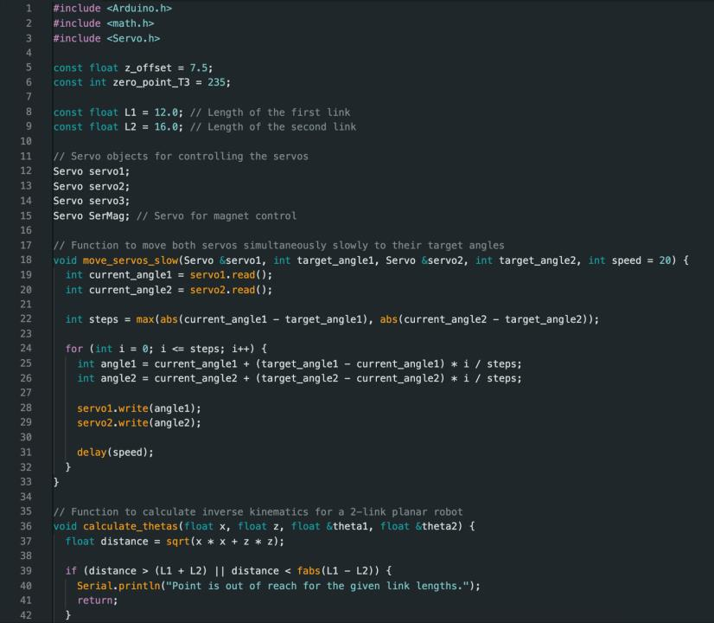
[picture p24: figure]

Figure 19. kode robot part1

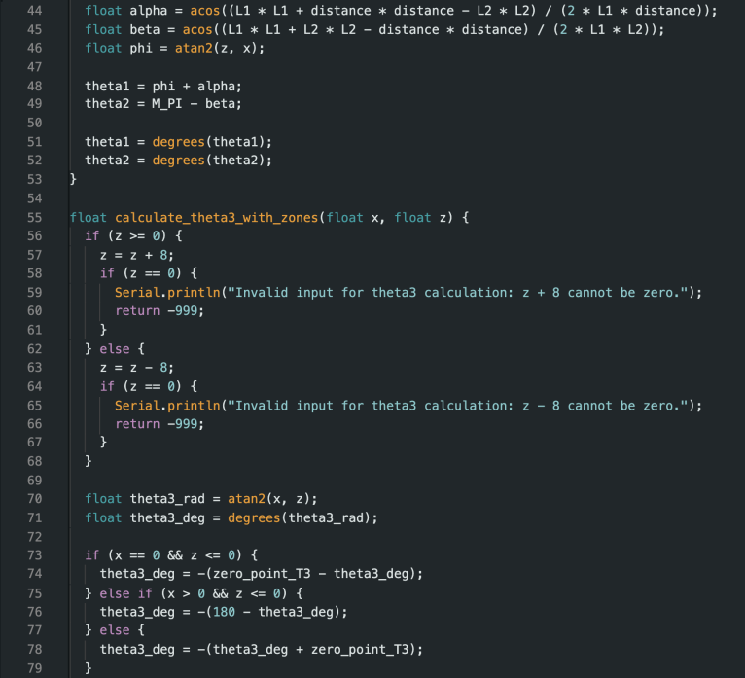
[picture p25: figure]

Figure 20. kode robot part2

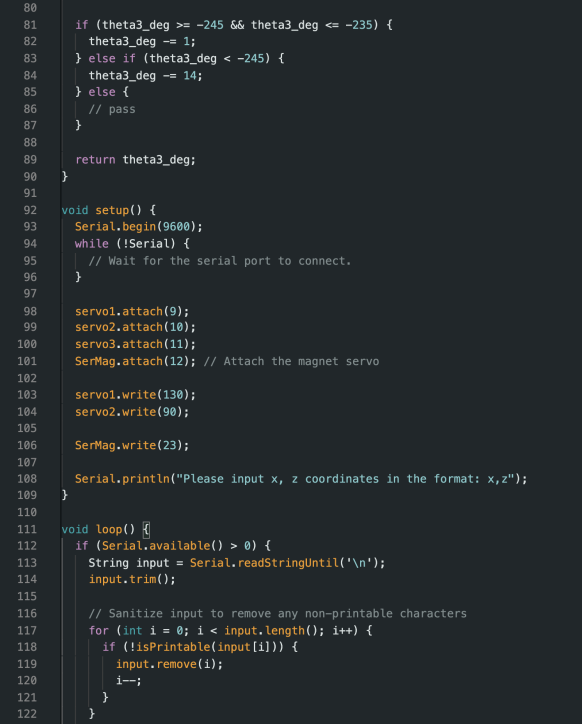
[picture p26: figure]

Figure 21. kode robot part3

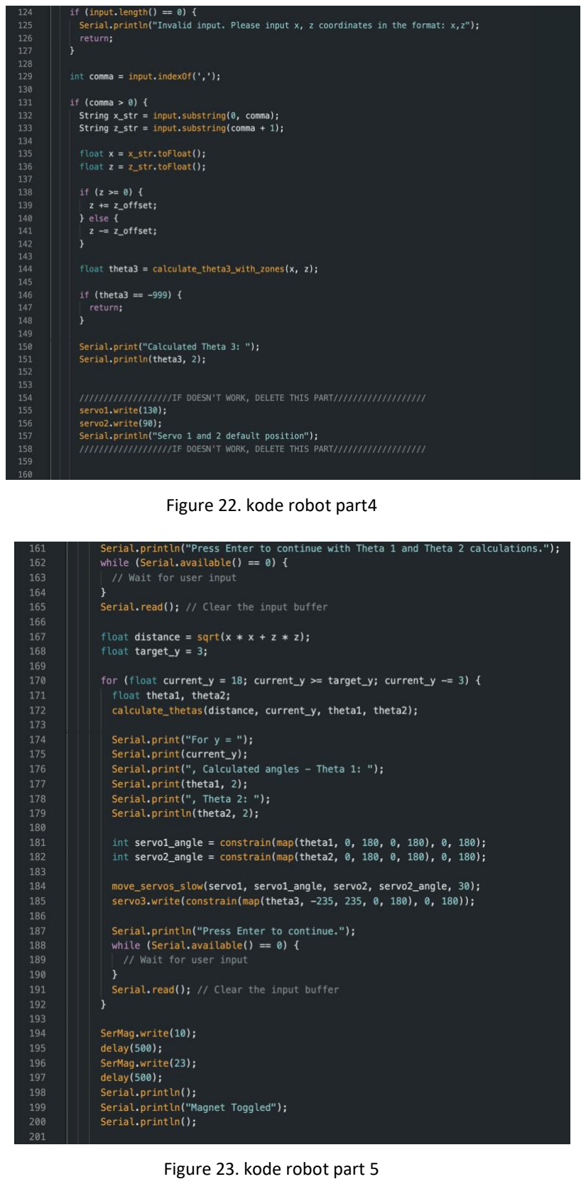
[picture p27: page 35]

Figure 22. kode robot part4

Figure 23. kode robot part 5

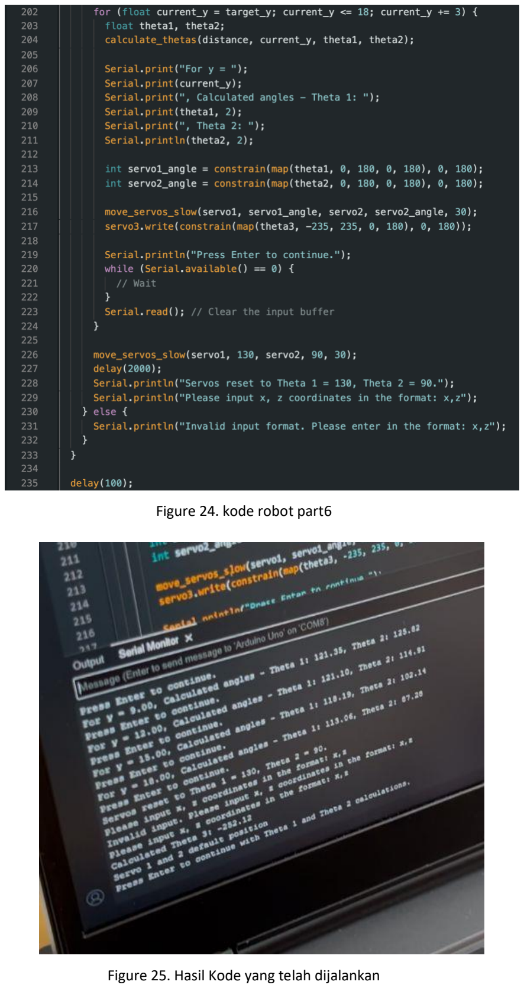
[picture p28: page 36]

Figure 24. kode robot part6

Figure 25. Hasil Kode yang telah dijalankan

Kode di atas merupakan implementasi untuk menghitung sudut pergerakan setiap sendi robot

dengan menggunakan metode trajectory planning dan inverse kinematics. Proses ini bertujuan untuk

menentukan nilai sudut θ (theta) yang optimal bagi servo agar dapat bergerak secara presisi. Nilai

sudut ini digunakan untuk menggerakkan sendi robot secara bersamaan guna mengambil objek yang

telah ditentukan berdasarkan koordinat hasil prediksi dari model machine learning.

Hasil dari kode ini menunjukkan keberhasilan integrasi antara perencanaan trayektori dan

metode kinematika terbalik, sehingga robot dapat bergerak dengan akurasi tinggi untuk

mengeksekusi tugasnya. Analisis ini membuktikan bahwa sistem mampu menghitung sudut gerakan

dengan tepat, sesuai dengan kebutuhan operasi pengambilan barang berdasarkan posisi yang telah

ditentukan.

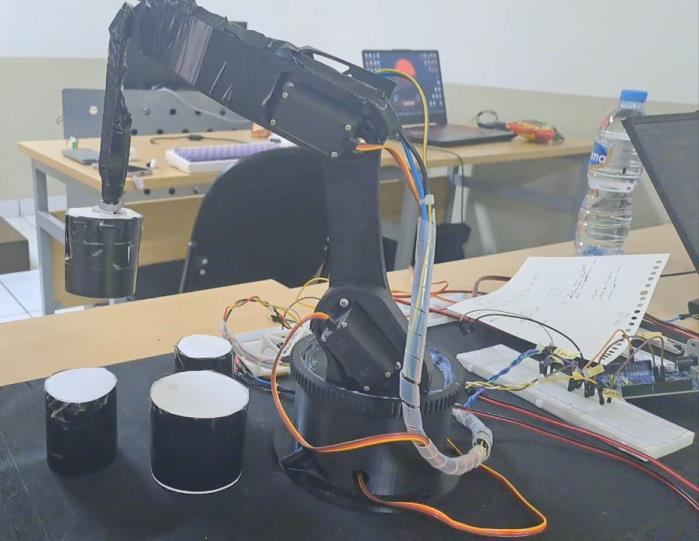
[picture p29: figure]

### 4.2 Hasil Machine Learning

Parameter eksperimen untuk menguji akurasi pixel mapping OpenCV:

- Tinggi Kamera dari alas : 43 cm

Figure 26. Robot yang bekerja

Trial Number | Expected | Predicted | Error
1 | 10.8 cm | 10.9 cm | 0.926%
2 | 5.6 cm | 5.2 cm | 7.142%
3 | 6.7 cm | 5.8 cm | 13.432%
4 | 11.7 cm | 10.9 cm | 6.838%
5 | 9.5 cm | 8.3 cm | 12.632%
6 | 21.5 cm | 22.4 cm | 4,186%
7 | 17.7 cm | 18.5 cm | 4.520%
8 | 8.7 cm | 8.7 cm | 0%
9 | 17.3 cm | 18.4 cm | 6.358%
10 | 7.2 cm | 7.2 cm | 0%

Mean Average Percentage Error : 5.603%

Model Accuracy : 94.397%

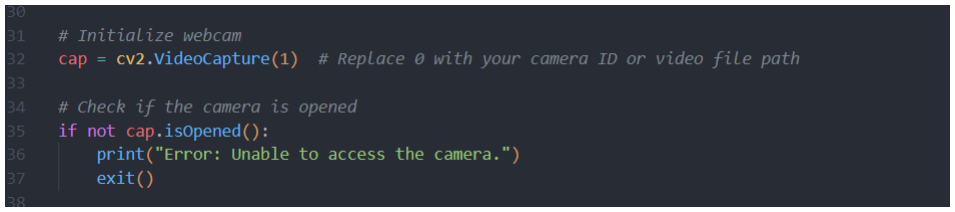
[picture p30: figure]

Figure 27. Turn on camera

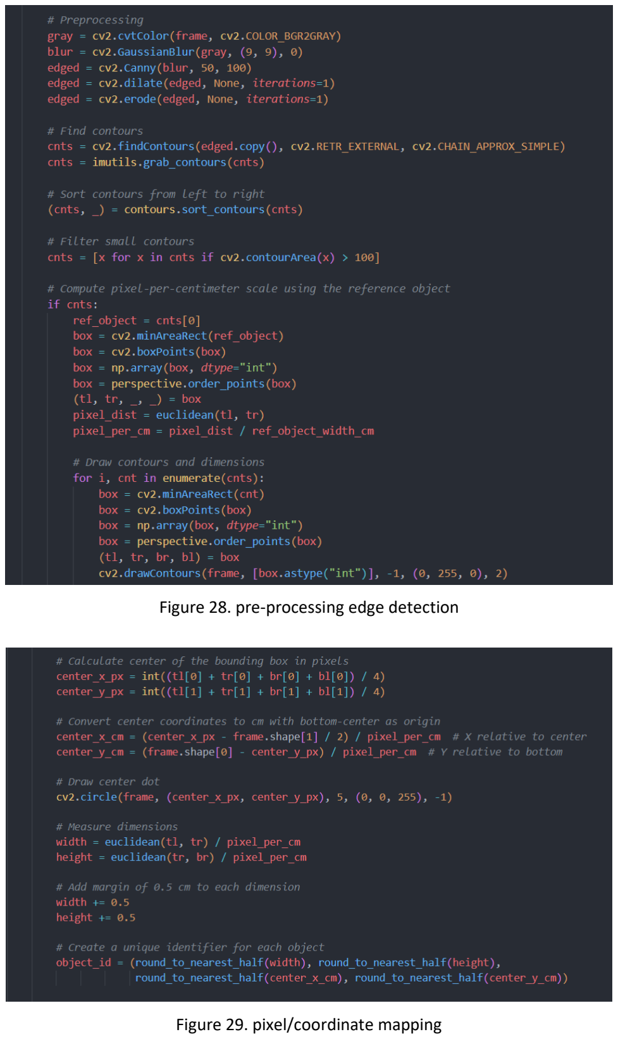
[picture p31: page 39]

Figure 28. pre-processing edge detection

Figure 29. pixel/coordinate mapping

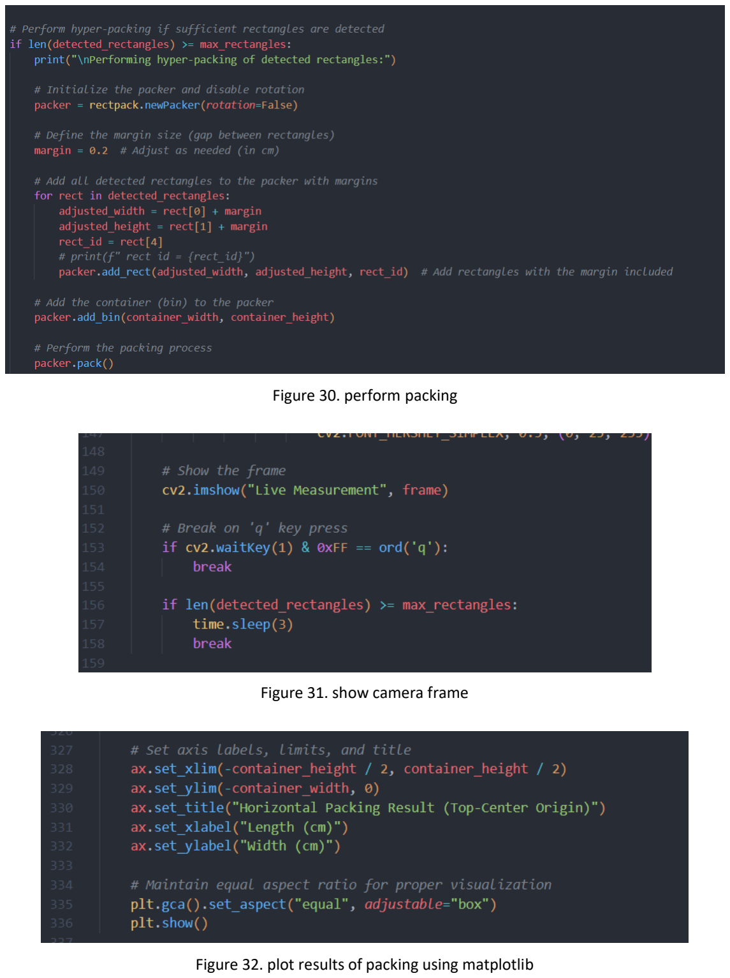
[picture p32: page 40]

Figure 30. perform packing

Figure 31. show camera frame

Figure 32. plot results of packing using matplotlib

### 4.2.1 ROS

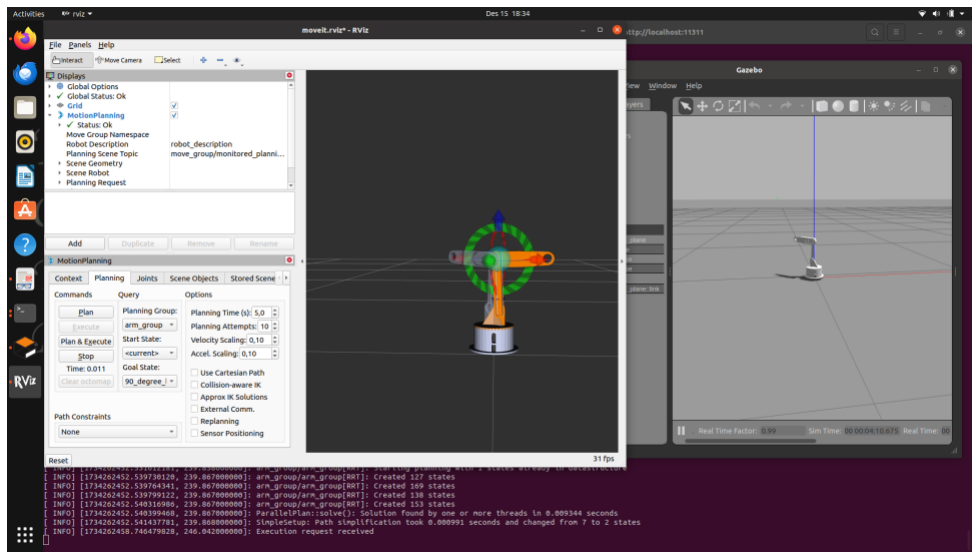
[picture p33: figure]

Figure 33. Model ROS di MoveIt dan Rviz

### 4.3 Hasil Control System

Seperti yang dijelaskan dalam prosedur, transfer function yang digunakan dalam sistem merupakan

fungsi dalam bentuk diskrit seperti berikut:
0.03594z + 0.01778
z

2 − 1.113 + 0.1125

Berikut adalah sistem yang digunakan untuk mensimulasikan sistem kontrol servo 360° pada alas

robot sudah diimplementasikan saturasi dan kontrol PID.

Figure 34. Sistem dengan PID dan saturasi

PID diimplementasikan berdasarkan output dari hasil root locus, yaitu nilai gain sebesar 5.47 untuk

proportional. Kemudian untuk integrator dan derivative diberikan nilai 0. Saturasi dalam sistem

diimplementasikan sebagai pembatas input agar terbatas di antara -12 dan +12. Terakhir, sampling

time dibuat agar terjadi setiap 0.1 detik. Sehingga menghasilkan grafik seperti berikut:

Figure 35. Hasil plot sistem dengan PID dan saturasi

Dapat dilihat bahwa hasil dari sistem tersebut mencapai nilai target secara stabil setelah sekitar 8

detik. Sistem tersebut memiliki waktu respon lebih lambat karena pembatasan sinyal kontrol dari

saturasi yang menghalangi kontroler memberikan aksi koreksi besar saat error masih besar. Saturasi

juga melindungi objek dari overload dengan membatasi input agar tetap dalam batas aman. Tanpa

saturasi, kontroler dapat mengurangi error lebih cepat, tetapi berisiko melebihi batas kemampuan

sistem.

## BAB V KESIMPULAN DAN SARAN

### 5.1 Kesimpulan

Penelitian ini berhasil mengembangkan sistem robot sorting yang mengintegrasikan teknologi

machine learning, inverse kinematics, dan trajectory planning untuk meningkatkan efisiensi

penyortiran barang di gudang. Sistem ini memanfaatkan algoritma computer vision (OpenCV) untuk

mendeteksi dimensi dan posisi barang, serta algoritma Rectpack untuk mengoptimalkan tata letak

barang. Hasil pengujian menunjukkan bahwa robot mampu menjalankan tugasnya dengan akurasi

tinggi, dengan nilai rata-rata kesalahan prediksi posisi sebesar 5,603%, yang menunjukkan efektivitas

integrasi teknologi ini.

Dari sisi mekanisme, robot tiga derajat kebebasan (3-DOF) yang dirancang menggunakan servo

motor 360° dan 180° telah mampu beroperasi sesuai perhitungan kinematika dan dinamika.

Perencanaan trayektori serta implementasi PID pada servo 360° memberikan kontrol yang stabil,

meskipun terdapat keterbatasan teknis seperti keharusan servo kembali ke posisi awal sebelum

menuju sudut tertentu. Meskipun demikian, robot menunjukkan performa yang konsisten dalam

mengangkat dan memindahkan objek berbentuk silinder menggunakan end-effector elektromagnetik.

Penelitian ini memberikan kontribusi nyata dalam meningkatkan efisiensi ruang, mempercepat

proses penyortiran, dan mengurangi risiko kecelakaan kerja di gudang. Namun, beberapa

keterbatasan, seperti sensitivitas sistem terhadap cahaya dan durasi penggunaan elektromagnet,

memerlukan perhatian lebih lanjut. Dengan pengembangan tambahan, seperti peningkatan desain

end-effector dan optimasi sistem deteksi visual, sistem ini memiliki potensi untuk diimplementasikan

secara luas dalam industri pergudangan modern.

### 5.2 Saran

Dalam penelitian ini, tentu ada beberapa batasan masalah yang harus diberlakukan baik karena

keterbatasan perlengkapan atau keterbatasan waktu. Pertama, barang-barang yang digunakan saat

testing robot berbentuk silinder, sehingga orientasi barang tidak menjadi masalah. Kedua,

dikarenakan panjang lengan robot yang tidak terlalu panjang, maka batas jangkauan robot

menyesuaikan dengan kemampuan robot. Ketiga, dikarenakan sistem machine learning pada

kamera yang bertujuan untuk mendeteksi posisi barang bekerja dengan cara “memisahkan” warna

yang lebih terang dari latarnya yang berwarna hitam, sistem rawan mendeteksi “noise” yang bukan

merupakan objek jika dijalankan dalam ruangan yang terang, sehingga cahaya harus diperhatikan

saat praktek. Keempat, dikarenakan end-effector pada robot menggunakan elektromagnet, end-

effector tidak boleh dinyalakan terlalu lama karena akan menyebabkan magnet menjadi panas dan

kekuatan medan magnet menjadi berkurang. Kelima, masih berhubungan dengan magnet, posisi

end-effector perlu dibantu agar menghadap ke bawah secara sempurna dikarenakan hanya

digantung menggunakan kabel yang cukup kaku.

## BAB VI REFERENSI

[1] Brosnan Property, “Warehouse Management: Top 6 Order Picking Problems and How to Solve Each,” 5 August 2023. [Online]. Available: https://www.globaltrademag.com/warehouse-management-top-6-order-picking-problems-and-how-to-solve-each/.
[2] Roberto Michel, “2018 Warehouse/Distribution Center Equipment Survey: Automation & Robotics Lead Robust Outlook,” Logistics Managements, 16 April 2018. [Online]. Available:
https://www.logisticsmgmt.com/article/2018_warehouse_distribution_center_equipment_survey_automation_robotics_1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,expect%20a %20decrease..
[3] Iris Dynamics, “Forward and Inverse Kinematics: Explained,” Iris Dynamics, 12 April 2023. [Online]. Available: https://irisdynamics.com/articles/forward-and-inverse-kinematics.
[4] M. Toussaint, “Robotics Dynamics,” University of Stuttgart, Stuttgart, 2015.
[5] R. Nilsson, “Iris Dynamics,” Master's Thesis, 2009.
[6] rosrobotics learning, “Jacobian,” rosrobotics learning, [Online]. Available: https://www.rosroboticslearning.com/jacobian.
[7] geeksforgeeks, “What is OpenCV Library?,” geeksforgeeks, 15 April 2024. [Online]. Available: https://www.geeksforgeeks.org/opencv-overview/.
[8] David Colson, “Exploring rectangle packing algorithms,” David Colson, 10 Maret 2020. [Online]. Available: https://www.david-colson.com/2020/03/10/exploring-rect-packing.html.
[9] ni, “The PID Controller & Theory Explained,” ni, 11 Desember 2024. [Online]. Available: https://www.ni.com/en/shop/labview/pid-theory-explained.html.
[10] V. Kanade, “What Is a Robot Operating System (ROS)? Meaning, Working, Applications, and Benefits,” spiceworks, 13 February 2024. [Online]. Available: https://www.spiceworks.com/tech/artificial-intelligence/articles/what-is-robot-operating-system/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,%2C%20simulation%2 C%20and%20hardware%20integration..
[11] moveit, “Moveit Concepts,” moveit, [Online]. Available: https://moveit.ai/documentation/concepts/#concepts.
[12] R. S. D. D. P. ADI SUCIPTO, “Gerak Robot Berkaki Dua menggunakan ROS dan RViz sebagai Visualisasi Interaktif,” ELKOMIKAL Jurnal, [Online]. Available: https://ejurnal.itenas.ac.id/index.php/elkomika/article/view/3834.
[13] The Construct, “[ROS in 5 mins] 028 – What is Gazebo simulation?,” The Construct, [Online]. Available: https://www.theconstruct.ai/ros-5-mins-028-gazebo-simulation/.
[14] L. Santana, L. Goes dan M. Maximo, “Artigo Servo,” Physical Modeling and Parameters Identification of the MG995 Servomotor, 2021.

## LAMPIRAN

### 1. Working Log Akhir (Recap)

Nama Anggota | Recap pengerjaan project
Willsan A Jantho | ⚫ | Membuat sistem feedback pada servo 360 menggunakan rotary
| | encoder sehingga servo 360 dapat berputar dengan akurat
| | menuju ke sudut theta yang diinginkan.
| ⚫ | Melakukan Research dan kalkulasi untuk Dinamika pada robot
| | agar dapat mengetahui torsi yang bekerja pada setiap sendi atau
| | joint.
| ⚫ | Membuat item yang diangkat oleh robot, dengan membuat
| | cylinder yang diberikan paperclip agar dapat diangkat oleh
| | elektromagnet yang merupakan end effector.
| ⚫ | Membuat sistem komunikasi anatara phyton (machine learning)
| | dengan arduino menggunakan pyserial (tidak jadi digunakan).
| ⚫ | Menyusun laporan akhir dan menuliskan bagian Robot
| | Kinematics & Dynamics pada laporan.
Raphael Nazareth | ⚫ Membuat perhitungan 2link arm dengan input xyz dari robot ⚫ Membuat coordinate system machine learning input & output dengan merapihkan titik (0.0) pada pengambilan menggunakan kamera dan penyimpanan barang menggunakan hyperpack ⚫ Membuat electromagnet dengan baut dan kabel ⚫ Menyusun trajectory planning linear interpolation ⚫ RnD offset system koordinat robot agar 2 link bekerja dengan baik ⚫ RnD Speed motor servo 360° 20kg ⚫ Membuat simscape simulation Kinematics yang disambungkan dengan solidworks di matlab ⚫ Membuat PPT presentasi akhir untuk Robot Kinematics & dynamics
Samuel Jordan Widjaja | ⚫ Melakukan riset awal terkait cara kerja rotary encoder ⚫ Membuat sistem untuk menentukan angle servo 360 menggunakan phytagoras ⚫ Turut berpartisipasi RnD mencari offset system koordinat robot & speed motor servo 360° 20kg ⚫ Pengaplikasiah sistem kontrol ke motor servo 360° ⚫ Turut berpartisipasi dalam pembuatan laporan
Efran Leonard Putra Satria | ⚫ 3D Model Robot ⚫ Bantu hitungan Inverse Kinematics ⚫ Trajectory Planning ⚫ Coding Arduino

Alifito Marciano
Camil
⚫ | Membuat simulasi RKD di dalam ROS menggunakan package
| Moveit-Rviz dan Gazebo.
⚫ | Membantu dalam zoning dan RnD sedangkan penentuan offset
| base servo 360 supaya inverse kinematic solver akurat.
⚫ | Membantu dalam zoning dan RnD sedangkan penentuan offset
| 2-link arm untuk trajectory planning pergerakan arm.
⚫ | Membantu dalam konversi Inverse Kinematics Solver dari
| Python ke C++ supaya bisa bekerja di dalam Arduino.
⚫ | Membuat solver Inverse Kinematics pertama untuk bagian 2-
| link arm robot output hanya theta 1 dan 2 (tidak digunnakan di
| prototype akhir).
⚫ | Membantu edit kode Machine Learning di dalam python
| supaya output koordinat dapat di kontrol user dengan menekan
| tombol enter.
⚫ | Menulis bagian terkait dengan Machine Learning di dalam
| laporan tugas akhir.
